jorgenrh/ET062G_VHDL_Range_Sensor/readme.md

Digital System Design with VHDL (ET062G) 

VHDL Range Measurement System

- Digilent Basys 3 Artix-7 FPGA
- SRF05 Range Sensor
- 12-bit VGA
- 7-Segment display

<!--
<center>
<img src="./images/system.png?raw=true" width="380" alt="System Overiew">
<img src="./images/design.png?raw=true" width="420" alt="Design Overiew">
</center>
-->
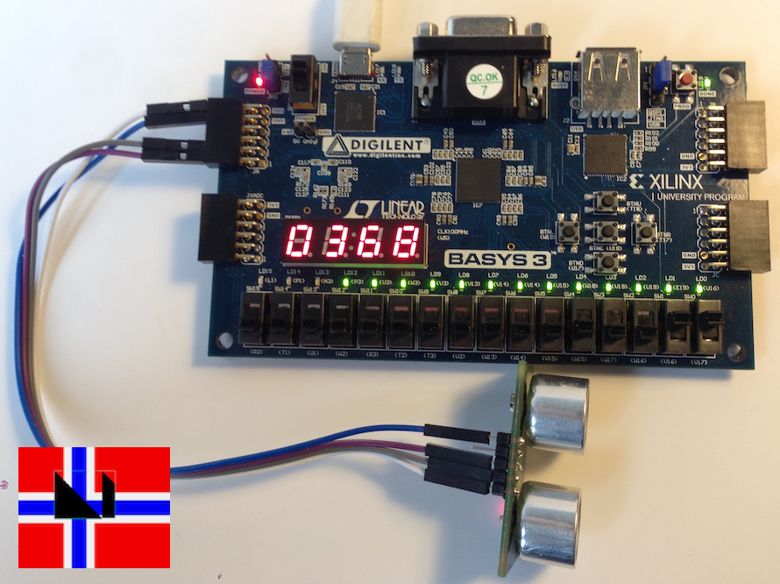
[picture p1: images/FPGA_SRF05.png]
VHDLProject FPGA Range Measurment System
