jorgenrh/ET062G_VHDL_Range_Sensor/reports/jrh_vhdl_report_ET062G.pdf

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

Abstract

This report describes the implementation, testing and results of a range measurement system using FPGA and VHDL. Besides the FPGA, the system is built using hardware such as a range sensor, VGA display, LEDs and 7-segement display. The system also makes use of hardware such as switches and push buttons for user interaction. The report is focused on the software side of the system in terms of VHDL and simulation and shows that the nal system is working accordingly to the project instructions.
The project is part of the Digital System Design with VHDL course (ET062G) at Mid Sweden University in Sundsvall, Sweden.

i

## Contents

1 Introduction | 1
2 Hardware | 2
3 Design and functionality | 4
4 Modules | 6
5 Simulation and verication | 16
6 Testing the system | 29
7 Results | 30
8 Discussion | 33
9 Conclusion | 33

ii

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

Introduction | J.R.Hoem
1 | Introduction

The main objective of this project is to learn how to interact with dierent kind of hardware using FPGA and VHDL. And gain experience in how to simulate, verify and test code as well as how to solve problems with VHDL.

The goal is to create a range measurement system using an ultrasonic range sensor, represent the data as a plot in a user-friendly manner on a VGA display, where the plot is surrounded by the ag of the student's home country.

For the sake of the length of this report, the report will assume that the reader has a basic understanding of VHDL, FPGA, VGA and Ultrasonic Range Sensors. This means that the report will not go in-depth on the hardware side of the project but instead focus on the software side in regards of implementation, simulation and verication.

The report will begin with a brief description of the required hardware. It will then present an overview of the design, and describe the code structure and functionality of the system.

All of the modules created and used in this project will be described before the simulations of the system is presented. The last part of the report will show how the testing of the system have been done, and then present the results in regards of accuracy and resource usage. The system as a whole will then be discussed before a short conclusion is given.

List of gures, tables and references can be found at the end of the report.

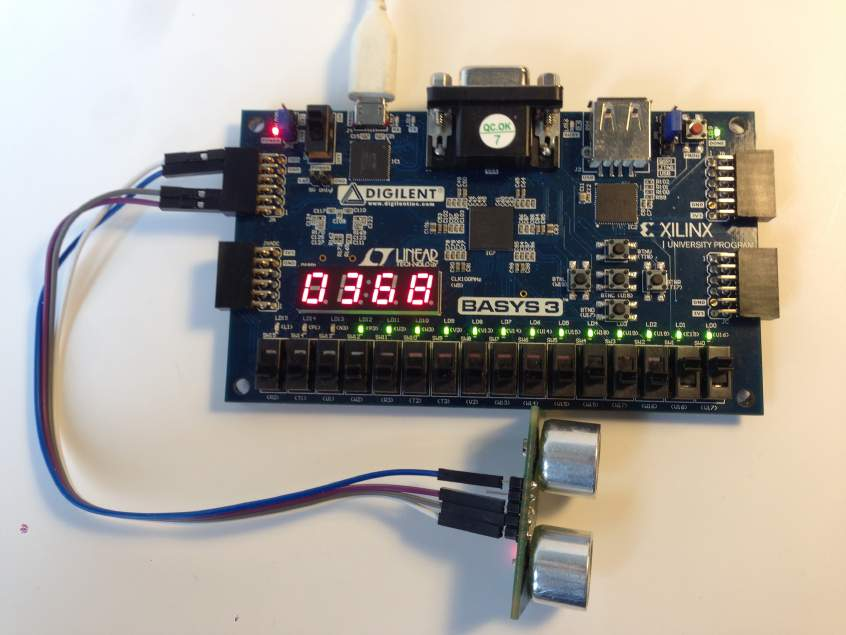
[picture p2: figure]

Figure 1: FPGA with the SRF05 connected

Digital System Design with VHDL (ET062G) | 1

J.R.Hoem | Hardware
2 | Hardware

This section will give a brief description of the hardware that is both required and used in this project.

2.1 The FPGA Development Board

The FPGA kit used in this project is the Basys 3 Artix-7 FPGA Trainer Board (Figure 1). This board contains the Xilinx Series-7 chip XC7A35T-1CPG236. Features that are most relevant to the project is listed in Table 1.

Basys 3 Artix-7 FPGA Trainer Board

Xilinx Artix-7 FPGA: XC7A35T-1CPG236 33,280 logic cells in 5200 slices
USB-powered (micro-B)
1,800 Kbits of fast block RAM
12-bit VGA output
16 user switches
16 user LEDs
5 user pushbuttons
4-digit 7-segment display

Table 1: Basys3 FPGA features

One of the goals have been to use as many of the boards peripherals as possible, such as the switches, LEDs, push buttons, 7-segment display and so forth.

2.2 | Ultrasonic Range Sensor

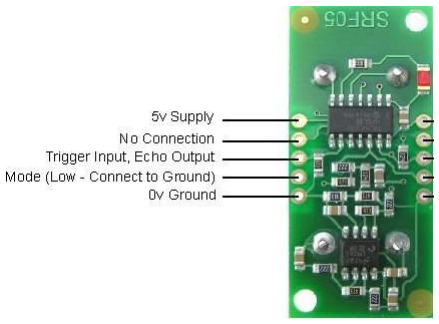
[picture p3: figure]
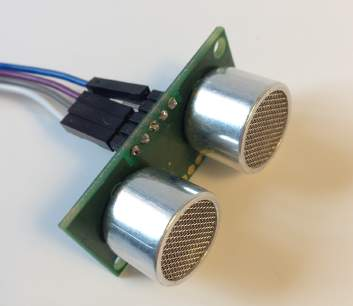
[picture p4: figure]

(a) SRF05 pinout | (b) SRF05

Figure 2: SRF05 ultrasonic range sensor

The range sensor used in this project is an ultrasonic range sensor called SRF05. This sensor is used in mode 1 which means that separate pins controls the sending and receiving of the trigger- and echo pulse.

2 | Digital System Design with VHDL (ET062G)

Hardware | J.R.Hoem

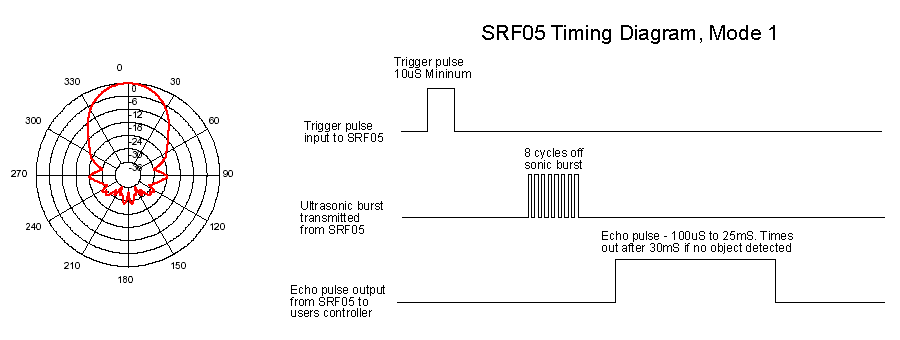
[picture p5: figure]

Figure 3: SRF05 beam prole and timing diagram

This sensor works by sending out an ultrasonic burst of 8 pulses at 40 kHz each time it receives a trigger pulse between 10 µs and 20 µs. The duration of the echo pulse will then represent the range. The range are then converted to centimeters by dividing the echo pulse length with 58.
Even though the SRF05 is rated for distances up to 400 cm (others claim 450 cm¹
), the timeout of the sensor is 30 ms which gives a theoretical range of up to 517 cm.

The sensor is rated for 5 VDC but have been supplied with 3.3 VDC directly from the FPGA board without any problems. This have been done to ease the process of testing.

2.3 VGA display

The FPGA provides an 12-bit VGA port which is used in this project. 12-bit VGA means that the RGB colors are represented with 4 bits each, hence RGB444.

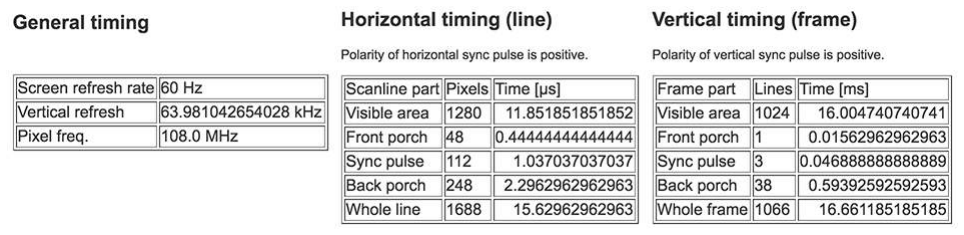
[picture p6: figure]

Figure 4: VGA timing data for 1280x1024 resolution[1]

The project is built using the VGA resolution 1280x1024 at a 60 Hz timing frequency. This requires a pixel clock of 108 MHz. Other key parameters used from Figure 4 is the vertical and horizontal front and back porch, and sync pulses.

1http://www.f15ijp.com/2012/09/arduino-ultrasonic-sensor-hc-sr04-or-hy-srf05/

Digital System Design with VHDL (ET062G) | 3

J.R.Hoem | Design and functionality
3 | Design and functionality
3.1 | Design overview

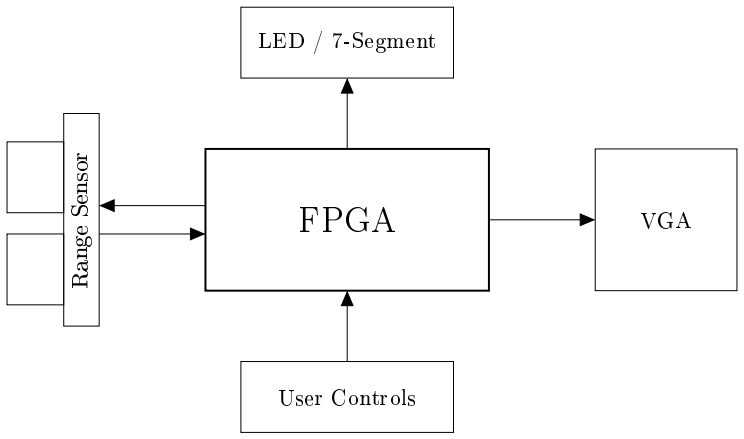
[picture p7: figure]
FPGA; Range Sensor; LED / 7-Segment; User Controls; VGA

Figure 5: System overview, block diagram

Figure 5 show the basic overview of the system and how the dierent hardware is interacting and connected together.

Clock | Top File

108 wiz

SRF05

Pulse | Echo | Divider

LED7Seg

BCD conv

VGA

RAM ctrl

BRAM

VGA ctrl | Flag

Figure 6: Design overview, block diagram

Figure 6 show how all of the VHDL components are structured and connected. One of the rst experiences gained from this project was that many components can quickly become quite messy. Thus, one of the important aspects have been to have a structured and logical component hierarchy.

3.2 Code description

All of the code is developed in Vivado 2015.1 with emphasizes to create a modular system and using material learned during the course. The code is also written as an attempt to follow best practices and the Xilinx guidelines.

4 | Digital System Design with VHDL (ET062G)

Design and functionality | J.R.Hoem

The system consist of a main top le that connects everything together. Subsystems, such as the VGA, SRF05 Sensor and so forth, are called cores and have the sux core in the entity- and le name. A core can can be considered as a driver for that particular subsystem and can contain processes as well as other components to work. Independent components, usually used by cores, have the sux module with exception of the Clock Generator.

Furthermore, all modules are written in lower case. General named signals have the sux in or out to avoid confusion. For clarity, port and generic mapping is done using named association instead of positional association. Files that are dependent of other components are using entity instantiation[2] instead of component instantiation. This is to make a leaner and more readable code that is less error-prone and less time consuming to change during the development.

Individual testbenches have been created for the main top le and each of the cores. With exception of the RAM module which has a verication module instead of a dedicated testbench. Though it has been manually simulated. Additionally, an individual testbench component have been made to simulate a VGA display. This is a standalone testbench component that is used both with the top le and the VGA core.

All of the les in this project is written by the author of this report, with exception of the 108 MHz clock generator and the VGA controller.

3.3 Functionality

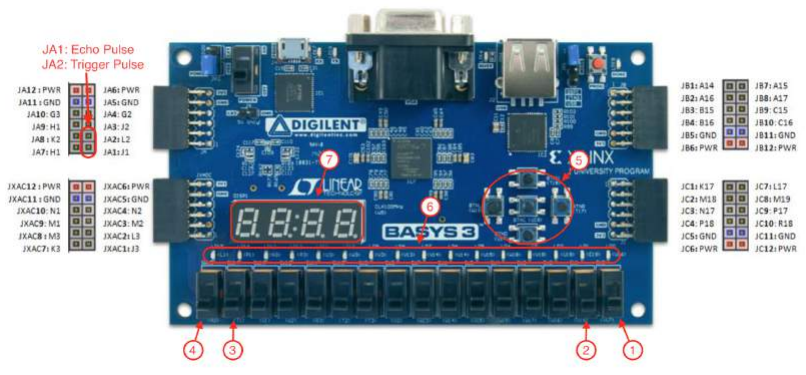
[picture p8: figure]

Figure 7: Board functionality map

1. Reset switch for the VGA (active low).
2. Enable switch for the range sensor (active high).
3. Switch for bisecting the sensor data displayed on the VGA. When on the full graph height is displayed, when o the height is divided by two.
4. Controls the data ow displayed on the VGA screen. When on the data is updated continuously, when o the data is only updated when new values occurs.
5. Control buttons, moves the graph to the desired location on the screen. The center button resets the position to default.
6. LED-meter that indicate the range from 0 to 450 cm, each LED represents 30 cm.
7. 7-segment display that shows the received sensor data in real time.
Digital System Design with VHDL (ET062G) | 5

J.R.Hoem | Modules
4 | Modules

This section will give a brief description of each of the cores and modules used in this project. Modules marked with extern in the title is not created by the author of this project. It is recommended to read the source code for a more in-depth description of the functionality.

4.1 Clock Generator

clock gen module

clock 100mhz in | clock 108mhz out clock 1mhz out

Figure 8: Entity of jrh_clock_gen_module.vhd

The clock generator was created to have one module that generate all of the necessary clock frequencies, 1 MHz and 108 MHz, for this project.

The 1 MHz clock, often referred to as the slow clock in this project, is made using a counter that downscale the 100 MHz input clock to 1 MHz. This clock drives all of the low speed components and functions such as the range sensor, RAM writing, LED-meter and the 7-segment display.

4.1.1 108 MHz clock (extern)

clk wiz 0

clk in1 | clk out1

Figure 9: Entity of clk_wiz_0.vhd

The 108 MHz clock is only used for the VGA display and thus also RAM reading. This clock is driven by the Mixed-Mode Clock Manager (MMCM) that is provided by the Xilinx FPGA. The code for this module was given with the instructions for laboratory exercise 1 and appears to be generated from a clock wizard. It has not been modied and is used as is.

6 | Digital System Design with VHDL (ET062G)

Modules | J.R.Hoem
4.2 | Range Sensor

srf05 core

clock in
enable in
echo pulse in

trig pulse out
distance out

Figure 10: Entity of jrh_srf05_core.vhd

The SRF05 core is the driver for the SRF05 Range Sensor and is dependent of three modules: Pulse generator, Echo pulse analyzer and a divider.

4.2.1 Pulse Generator

pulse gen module

clock in
enable in
pwidth in

pulse out

Figure 11: Entity of jrh_pulse_gen_module.vhd

The pulse generator module activates the range measurement by sending a trigger pulse to the sensor. The frequency of this pulse is 10 Hz and is sent continuously as long as the enable_in is set high. In other words, the enable_in signal controls whether or not the sensor is activated.

Due to the requirements from laboratory exercise 3 the code is structured so that the pulse width can be adjusted between 10 µs and 20 µs during runtime. This functionality have been partly disabled and the pulse width is set with a static width of 15 µs for this project.

4.2.2 Echo Pulse Analyzer

echo analyzer module

clock in
pulse in

duration out

Figure 12: Entity of jrh_echo_analyzer_module.vhd

The purpose of the echo analyzer is to measure the duration of the response pulse from the SRF05 sensor.
The duration is measured using a counter, and according to the SRF05 datasheet[3] a timeout occurs if the duration exceeds 30 ms this is also handled by this module. To avoid inconsistency in the readout the most recent duration value is set on the duration_out signal, this prevents ickering when new echo pulses arrives.
Digital System Design with VHDL (ET062G) | 7

J.R.Hoem | Modules
4.2.3 | 58 Divider

divider module

clock in
data in

data out

Figure 13: Entity of jrh_divider_module.vhd

The divider module have one task and that is to convert the duration received from the echo analyzer to centimeters. This is done by dividing the pulse duration with the number 58[3]

The distance is saved in a 16-bit wide logic vector, this size is used throughout the system with exception of the RAM. The reason for using 16-bit instead of the minimum 9-bit required is due to laboratory exercise 3 where pulse widths way above 400 µs was tested.

Since regular division requires a lot of resources and should be avoided on the FPGA, bitshifting have been used for division, as shown below.

Division (from jrh_divider_module.vhd)

37 | if to_integer(unsigned(data_in)) < 58 then
38 | data_out <= (others => ’0’);
39 | else
40 | -- since regular division should be avoided, (2^16)/58 = 1129,9 =>
| 1130.
41 | data_out <= std_logic_vector(resize(resize(unsigned(data_in) * 1130,
32) srl 16, 16));
42 end if;

For all values below 58 the data_out signal is set to 0. Other values is multiplied with 1130 into a temporary storage of 32 bits to avoid overow. It is then right shifted 16 positions and resized to a depth of 16 bits. The number 1130 comes from 2

16/58 = 1129.93 ≈ 1130 where 16 is the size of the logic vector.

This method was tested using Python²
. The result of the test showed that the approximation of 1130 can give an error of 0.78 %, at least in Python. In practice, this means that distances from 282 cm is rounded one up, 282 cm becomes 283 cm and so forth. This error could easily be accounted for in the code but since the range sensor already have an uncertainty of measurement[4] this have not been done.

4.3 RAM

The RAM implementation consists of two modules: the main RAM module and a RAM controller. Both modules are written with exibility and reuse in mind, and are therefor using generic variables to set the RAM length and depth, and address size.

2Python - https://www.python.org/

8 | Digital System Design with VHDL (ET062G)

Modules | J.R.Hoem
4.3.1 | RAM Module

ram module

clock in
read en
write en
read addr
write addr
write data

read data

Figure 14: Entity of jrh_ram_module.vhd

The RAM module is implemented as a generic RAM module with enable signals for read and write, signals for data input and output, and a signal for setting the read address and write data.

One of the goals have been to keep the RAM module as simple as possible and keep the structure more or less identical to the one written for laboratory exercise 2. Even though the size of the sensor data has a depth of 16 bits throughout this project, the storage in the RAM module is limited to the minimum size necessary which is a depth of 9 bits. This gives the RAM a size that is just above 4k, 512 × 9 = 4608 bit

The RAM is implemented as Block RAM to follow best practices. This is explained more thoroughly in section 5.4.1.

4.3.2 RAM Controller

ram ctrl module

clock in
write data
read addr

read data

continuous

Figure 15: Entity of jrh_ram_ctrl_module.vhd

The RAM controller works as a circular buer³
(also known as ring buer). One counter keeps track of the write index of the RAM memory. This index increases for each data that is written, and the read address is shifted accordingly in the controller as shown in Figure 16.

The controller also takes care of the read and write enable signals, and if the data should be written continuously or for new values only.

By implementing the RAM controller as a circular buer the RAM module is used as a simplied FIFO without modifying the RAM module itself.

3http://www.embedded.com/electronics-blogs/embedded-round-table/4419407/The-ring-buffer

Digital System Design with VHDL (ET062G) | 9

J.R.Hoem | Modules
0 | 1 | 2 | 3 | 4 | 5 | 6 | 7 | 8

write index

read index 0, 1, 2, . . .

RAM memory

Figure 16: Principle of circular buers, when increasing the write index the read index is shifted accordingly

4.4 VGA Display

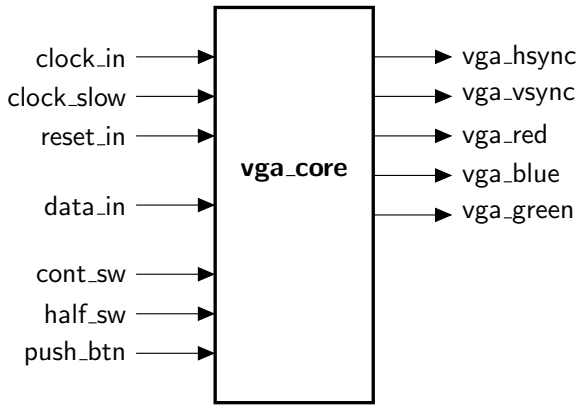
[picture p9: figure]
vga core; clock in clock slow reset in; data in; cont sw half sw push btn; vga hsync vga vsync; vga red vga blue vga green

Figure 17: Entity of jrh_vga_core.vhd

The VGA core is one of the more comprehensive sections in this project. It consists of three processes: sending data to the RAM controller, present the data on screen, controlling the position and layout of the presented data. It is also dependent of the RAM controller module, Flag Pattern module and the VGA controller module.

Saving Data Process

This process is pretty straight forward. It is a synchronous process using the slow clock (1 MHz), constrains the sensor data within 0 to 400 and sends it to the RAM controller which takes care of when and how it is saved.

Graphics Process

This process takes care of all the graphical elements drawn on the VGA display, such as the ag pattern, graph frame, horizontal meter and vertical bar plot. The data is read from the RAM controller and is clocked with the VGA clock at 108 MHz.

The division of the vertical bar plot height is also calculated in this process. This is controlled by a switch and is done the same way as the divider in the SRF05 core, using bit shifting to avoid regular division in the code.

Division of bar plot (from jrh_vga_core.vhd)

152 | if half_sw = ’0’ then
153 | -- if half size, divide data by 2 using right shift
154 | -- since regular division should be avoided, 2^9/2 = 256.
155 | data := to_integer(resize(resize(unsigned(read_data) * 256, 18) srl
| 9, 9));
10 | Digital System Design with VHDL (ET062G)

Modules | J.R.Hoem
156 | graph_h := 200;
157 | else
158 | data := to_integer(unsigned(read_data));
159 | graph_h := 400;
160 | end if;

Animation Process

This process uses all of the push buttons on the Basys3 board to control the position of the graph on the screen. The movement is controlled with a simple state machine where all of the four directions has its own state.

Setting move state (from jrh_vga_core.vhd)

271 if move = IDLE then

272
273 | if push_btn(0) = ’1’ then -- center
274 | graph_x := 703;
275 | graph_y := 100;
276 | elsif push_btn(1) = ’1’ then -- up
277 | y_end := graph_y - 10;
278 | move := MOVE_UP;
279 | elsif push_btn(2) = ’1’ then -- left
280 | x_end := graph_x - 10;
281 | move := MOVE_LEFT;
282 | elsif push_btn(3) = ’1’ then -- right
283 | x_end := graph_x + 10;
284 | move := MOVE_RIGHT;
285 | elsif push_btn(4) = ’1’ then -- down
286 | y_end := graph_y + 10;
287 | move := MOVE_DOWN;
288 | end if;

289
290 end if;

When one of the four buttons are pressed, a shared variable used by the Graphic Process will either increase or decrease depending on which state that is activated. The position update frequency is 200 Hz to give a smooth but notable transmission.The fth push button is used to reset the graph to the default position.

4.4.1 VGA Controller (extern)

vga ctrl module

pixel clk
reset n

h sync
v sync
disp ena
column
row
n blank
n sync

Figure 18: Entity of vga_ctrl_module.vhd

Digital System Design with VHDL (ET062G) | 11

J.R.Hoem | Modules

The VGA controller is the same as the one given for laboratory exercise 1. This code have not been modied and is used as is.

4.4.2 Flag Pattern

norwegian flag pattern

enable in
row
column

red
green
blue

Figure 19: Entity of jrh_norwegian_ag_pattern.vhd

The ag pattern module is heavily based on the pattern module given with laboratory exercise 1. This module uses the row and column position given by the VGA controller to determine which RGB444 color that should be sent to the VGA display.

This module can be considered as a background pattern for the VGA core and should thus be easy to replace with another pattern module with the same signal structure.

4.4.3 VGA Simulator (testbench component)

testbench comp vga2bmp

clock in

vga hsync
vga vsync

vga red
vga green
vga blue

snapshot

reading

Figure 20: Entity of testbench_comp_vga2bmp.vhd

The VGA simulator have been one of the more challenging but fun components created for this project. It is an addition to the VGA testbench and was created because it seemed like the best possible way to test the VGA core.

The purpose of the VGA simulator is to act as a real VGA display, therefore, it requires only the standard VGA signals to save one VGA frame as BMP if the snapshot is set high. The output signal, reading, is set high while the simulator is capturing.

This testbench component was created with reuse in mind, meaning the only conguration needed is width and height of the display, and vertical and horizontal back porch settings of the resolution.

VGA simulator conguration

1 | generic(
2 | bmp_width | : integer := 1280;
3 | bmp_height : integer := 1024;
4 | h_bporch | : integer := 248;
12 | Digital System Design with VHDL (ET062G)

Modules | J.R.Hoem
5 | v_bporch | : integer := 38;
6 | file_name | : string | := "C:\VHDL\VGA_output.bmp"
7 | );

The frame capturing works by waiting for the rst vertical sync signal if the snapshot signal is set high. When the vertical sync is received it compensates for the vertical back porch, before it starts capturing the RGB data between each horizontal sync pulse and horizontal back porch compensation.

The RGB data is converted from RGB444 to RGB888 and saved to a 2-dimensional array during capturing. When the frame is full the BMP header is created and the RGB array is reversed and written to the output le.

4.5 LEDs and 7-Segment Display

led7seg core

clock in
binary in

segment out
position out
led out

Figure 21: Entity of jrh_led7seg_core.vhd

This core serves as an direct indicator for the sensor value, meaning it does not store the data in RAM but output the data to the 7-segment display and 16 user LEDs directly. The advantages of this is that the raw distance can be read without any constrains, i.e. if the value exceeds the 400 cm range.

Two processes are used, one for controlling the LED-meter and one for the 7-segment display.

LED-meter Process

The LED-meter is a synchronous process using the slow clock. It is using Equation 1 to convert the distance into binary ones respectively.

led_out(d) = 2

16×

d
450
− 1 | (1)

To avoid dynamic (mathematical) operations within the code this formula have been translated into a static case structure where each case represent a step of 30 cm up to 450 cm. The upper limit of 450 cm is set intentionally since the sensor range in theory can exceed 400 cm.

7-Segment Display Process

The 7-segment display used is the one on the Basys3 board, this is a scanning display where the signals (LEDs) are active low[5]. The position of the digit is set low (active) and the 7 LEDs are turned on or o accordingly as shown in Figure 22.

Digital System Design with VHDL (ET062G) | 13

J.R.Hoem | Modules

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
abcdefg

0001111

Figure 22: 7-Segment Display numbering

The 7-segment display is driven by the slow clock (1 MHz). Two case structures are used, one for translating the BCD into the 7 segments respectively and one for the position of the digit. The update frequency of the display is set to 1 kHz, this is the fastest possible refresh rate according to the documentation.

Digit | 7-Segment | BCD
0 | 0000001 | 0000
1 | 1001111 | 0001
2 | 0010010 | 0010
3 | 0000110 | 0011
4 | 1001100 | 0100
5 | 0100100 | 0101
6 | 0100000 | 0110
7 | 0001111 | 0111
8 | 0000000 | 1000
9 | 0000100 | 1001

Table 2: 7-Segment Display conversion

The BCD conversion for the 7-segment display is dependent of the module described below.

4.5.1 Binary to BCD conversion

bin to 4bcd module

binary in | bcd3 bcd2 bcd1 bcd0

Figure 23: Entity of jrh_bin_to_4bcd_module.vhd

This module converts a 16 bit binary number into 4 binary-coded decimals (BCD). This is done by splitting the 16 bit number into 4 parts and then adjusting the 4 segments accordingly. The code is inspired from an online tutorial⁴

4http://www.deathbylogic.com/2013/12/binary-to-binary-coded-decimal-bcd-converter/

14 | Digital System Design with VHDL (ET062G)

Modules | J.R.Hoem
4.6 | Main Top le

jrh main top

clock in
enable in
reset in

echo pulse in

trig pulse out
led out

lcd segment
lcd position

vga hsync
vga vsync
vga red
vga blue
vga green

cont sw
half sw
push btn

Figure 24: Entity of jrh_main_top.vhd

The top le connects all the cores and modules together and does not contain any processes. The internal signals are distributed to each of the cores respectively, and the input/output signals are connect to the board through the constraint le.

The content of the top le can be viewed in Appendix 10.B or be found in Appendix 10.A.

Digital System Design with VHDL (ET062G) | 15

## 5 Simulation and verication

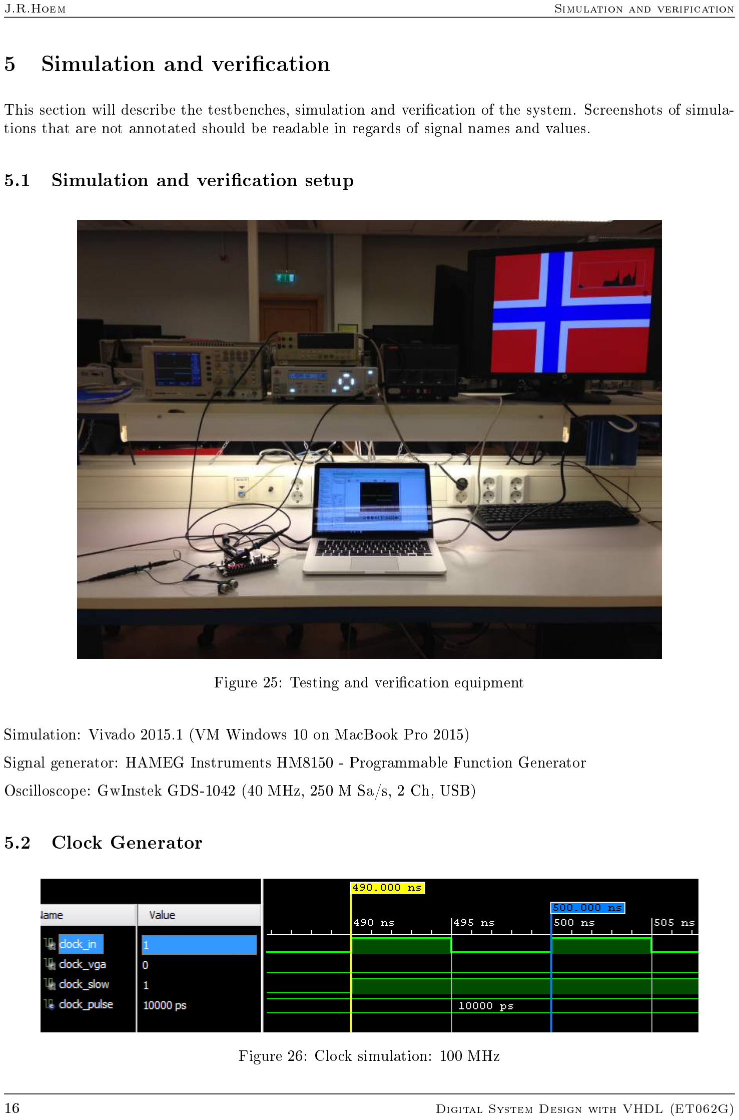
[picture p10: page 21]

J.R.Hoem | Simulation and verification

This section will describe the testbenches, simulation and verication of the system. Screenshots of simulations that are not annotated should be readable in regards of signal names and values.

5.1 Simulation and verication setup

Figure 25: Testing and verication equipment

Simulation: Vivado 2015.1 (VM Windows 10 on MacBook Pro 2015)

Signal generator: HAMEG Instruments HM8150 - Programmable Function Generator

Oscilloscope: GwInstek GDS-1042 (40 MHz, 250 M Sa/s, 2 Ch, USB)

5.2 Clock Generator

Figure 26: Clock simulation: 100 MHz

16 | Digital System Design with VHDL (ET062G)

Simulation and verification | J.R.Hoem

f =

1
500 ns − 490 ns
= 100 MHz | (2)

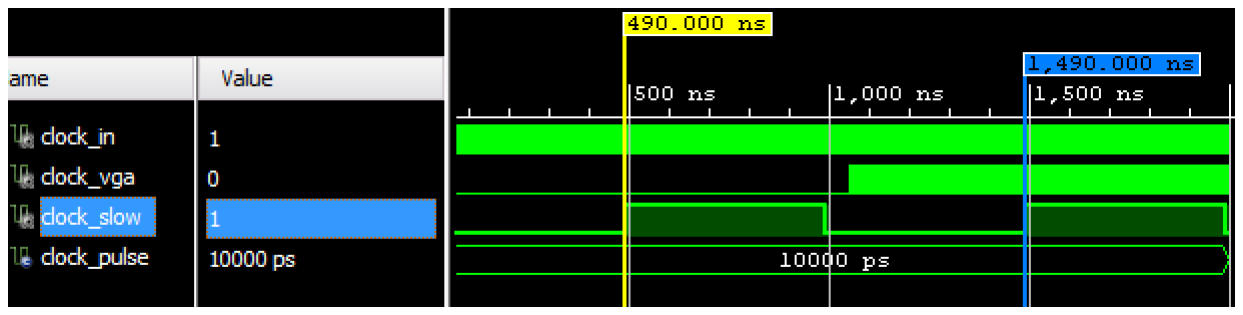
[picture p11: figure]

Figure 27: Clock simulation: 1 MHz

f =

1
1490 ns − 490 ns
= 1 MHz | (3)

The 1 MHz clock was veried using an oscilloscope, unfortunately, this was not documented at the time being.

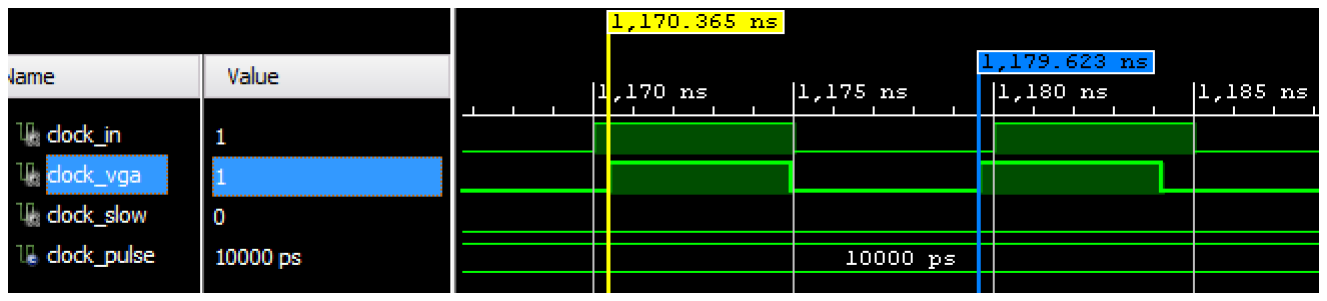
[picture p12: figure]

Figure 28: Clock simulation: 108 MHz

f =

1
1179.623 ns − 1170.365 ns
= 108 014 690 Hz ≈ 108 MHz | (4)
5.3 | Range Sensor

Manual simulation and testing have been done for each of the modules during development, the simulations described here will therefore only be based on the dedicated testbench since this summarizes the overall functionality.

5.3.1 Simulation

The testbench generates an echo pulse for each trigger pulse it receives. The echo pulse width is increased by 58 µs for every iteration.

Digital System Design with VHDL (ET062G) | 17

J.R.Hoem | Simulation and verification

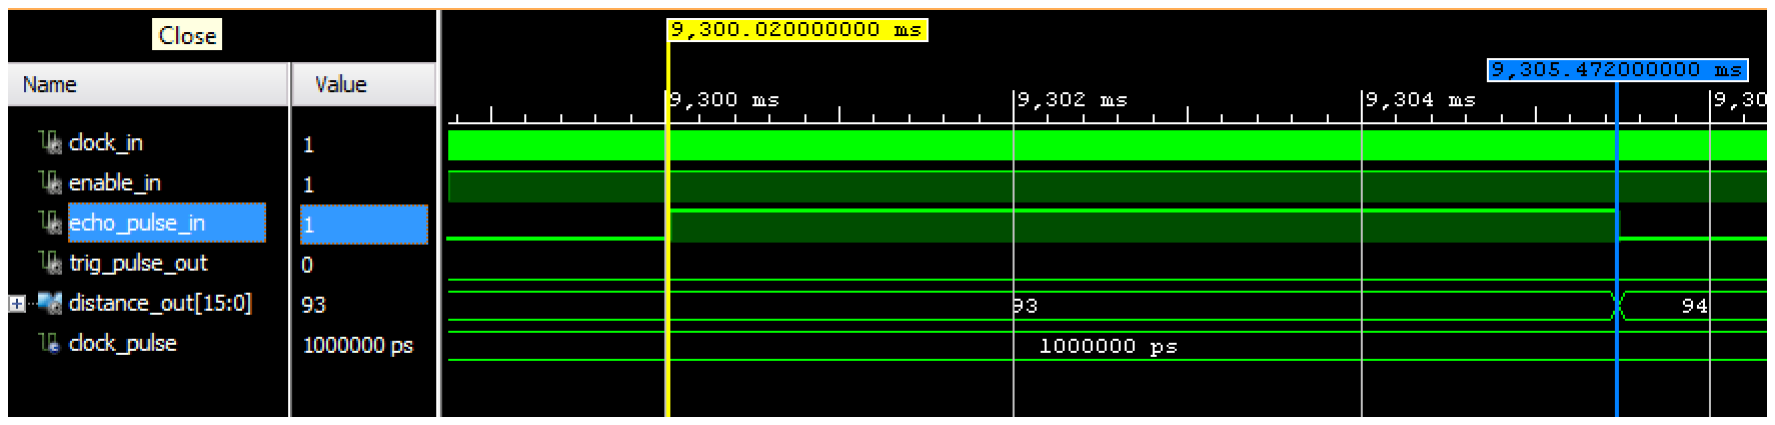
[picture p13: figure]

Figure 29: SRF05 simulation: echo pulse

Figure 29 shows a section from the simulation where the distance is 94 cm. By looking at the rising and falling edge of the echo pulse the distance is conrmed as shown in Equation 5.

d =

9305472 − 9300020
58
= 94 | (5)

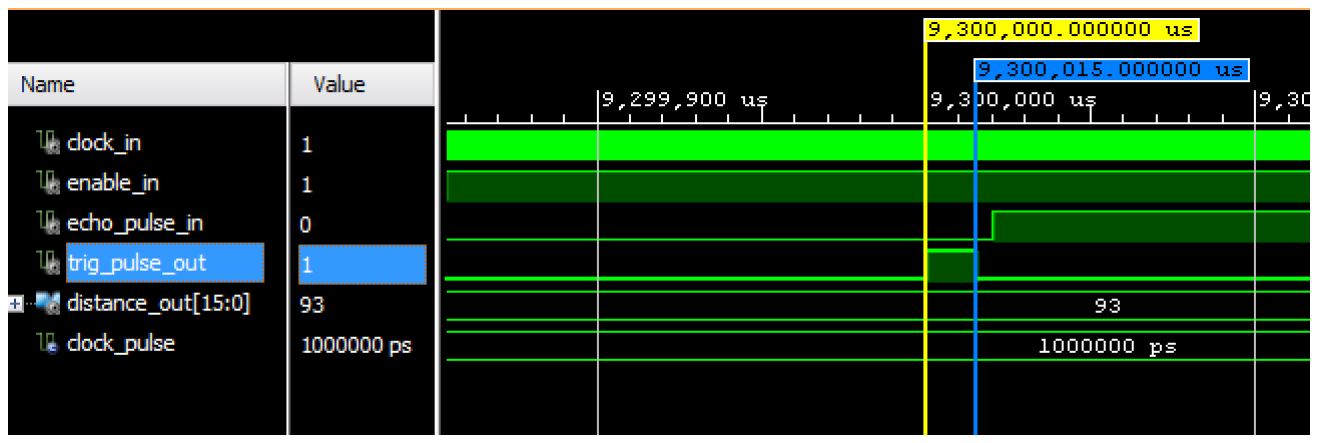
[picture p14: figure]

Figure 30: SRF05 simulation: trigger pulse width

A closer look at the trigger pulse shows that the width of the pulse is 15 µs.

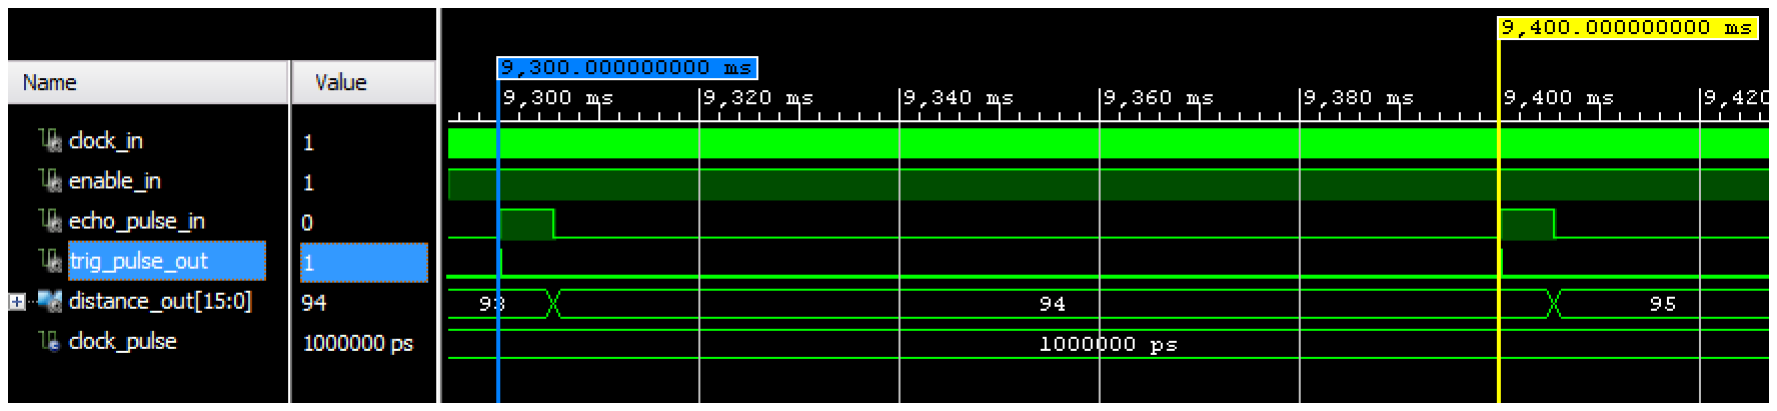
[picture p15: figure]

Figure 31: SRF05 simulation: trigger interval

The simulation also shows that the trigger pulse has an interval of 100 ms which gives a frequency of 10 Hz.

18 | Digital System Design with VHDL (ET062G)

Simulation and verification | J.R.Hoem
5.3.2 | Verication

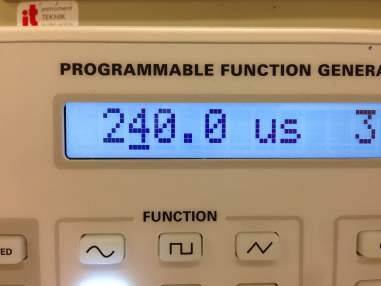
[picture p16: figure]
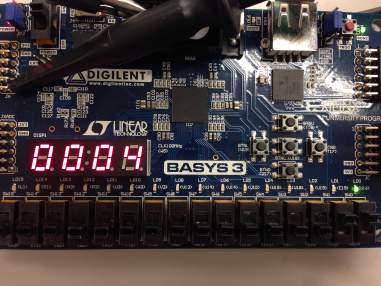
[picture p17: figure]

(a) Signal generator | (b) Board output

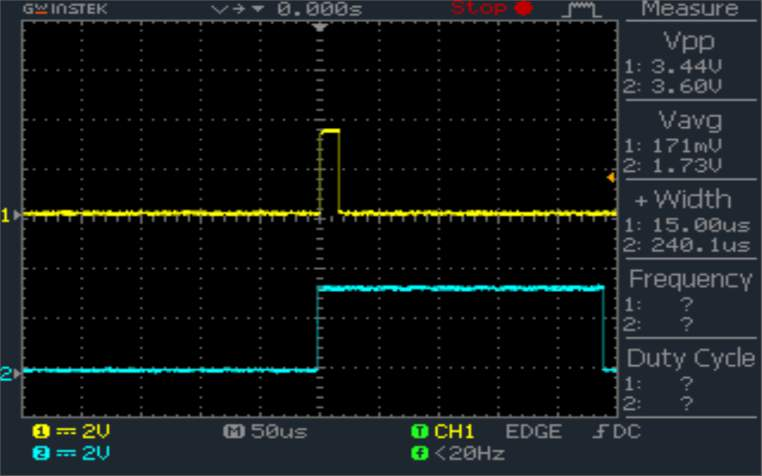
[picture p18: figure]

(c) Oscilloscope output of trigger pulse and echo pulse

Figure 32: Verifying SRF05 sensor using signal generator and scope

Figure 32 shows the verication of the echo pulse calculation. The signal generator simulates a 240 µs wide echo pulse that the FPGA translates to 4 cm. This is conrmed to be correct in Equation 6.

d =

240
58
= 4.1379 ≈ 4 | (6)

Figure 32b also shows the width of the trigger pulse to be 15 µs as the simulation indicated. A lot of dierent sized echo pulses was generated without any incorrect results. By generating a narrow echo pulse, such as the one in Figure 32a, the SRF05 core show that it is able to handle short distances.

Digital System Design with VHDL (ET062G) | 19

J.R.Hoem | Simulation and verification
5.4 | RAM
5.4.1 | Implementation

There are three ways of implementing RAM on the Xilinx FPGA. Dene it as RAM using LUTRAM (Distributed RAM) or BRAM (Block RAM), or using regular LUT/FF for implementation. Each of these methods have been tested and compared to nd the best suited implementation for this project.

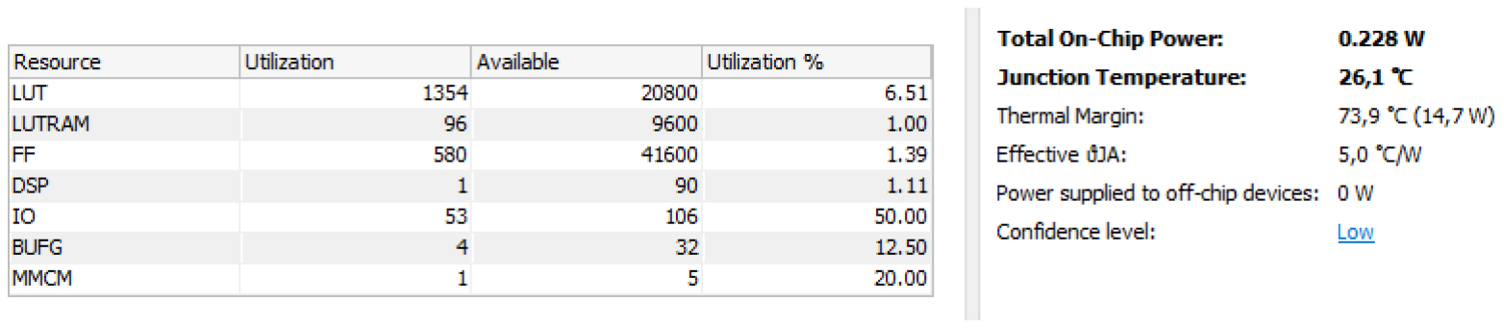
[picture p19: figure]

(a) LUTRAM implementation

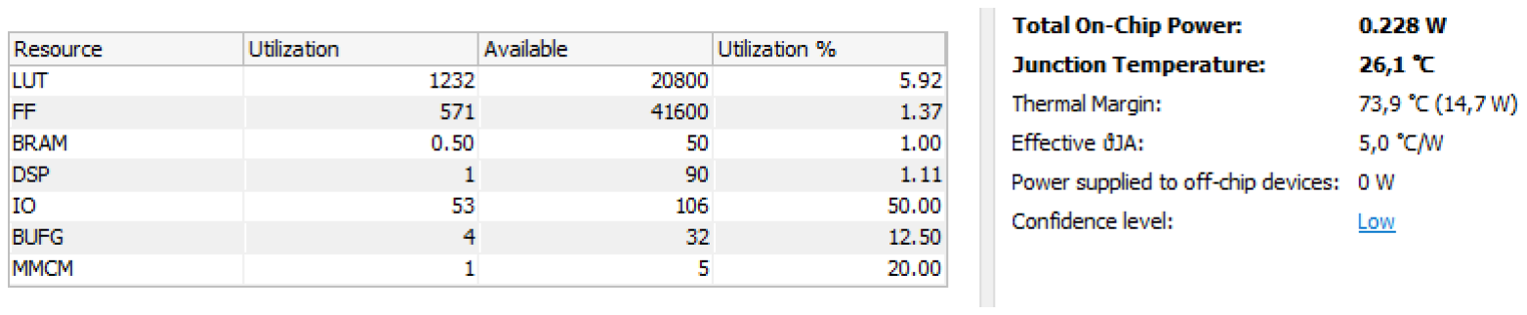
[picture p20: figure]

(b) BRAM implementation

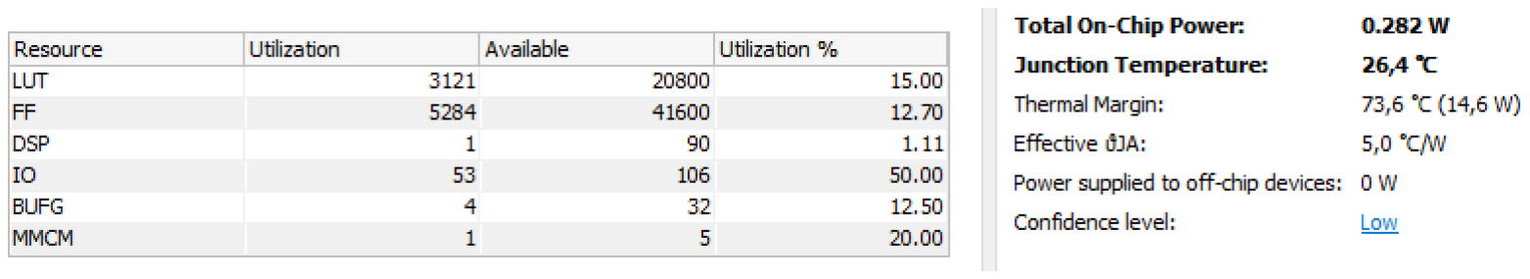
[picture p21: figure]

(c) LUT/FF implementation

Figure 33: Dierent RAM implementations

According to the Xilinx documentation as a rule of thumb, memory sizes below 4 kbit should be implemented as LUTRAM and anything above as BRAM[6]. As mentioned earlier the memory size in this project is 4.608 kbit which is quite close to 4k. Comparing LUTRAM against BRAM, as expected, did not show any major dierences. Except that BRAM gives slight reduction in the use of LUT and FF. The documentation shows that a more critical dierence between LUTRAM and BRAM is to be expected if the memory size is lager.

A more notable dierence arise when comparing LUTRAM and BRAM against LUT/FF, this concerns both power consumption and junction temperature. Using LUT/FF increases the power consumption around 23 %, from 0.228W to 0.282W, and the junction temperature by 0.3

◦C.

As a result of this the RAM in this project has been implemented as BRAM. This also makes it easier to expand the memory size for free in future revisions, if needed, without compromising the power consumption. It should be noted that the BRAM has a delay of one clock cycle, but this is not an issue in this project.

20 | Digital System Design with VHDL (ET062G)

Simulation and verification | J.R.Hoem
5.4.2 | Simulation

A verication module have been created for the RAM module instead of a dedicated testbench. This is to be able to test and verify the memory behavior using the switches on the Basys3 board. The verication module lls the RAM with data from 0 to 399, 9 of the switches on the board sets the read address and the read data is displayed as a binary value using the LEDs.

| RAM verication (from verication_ram_module.vhd)
72 | if ram_full = ’1’ then -- read address by using switches

73
74 | read_en <= ’1’;
75 | read_addr <= switch_in;
76 | led_out <= read_data;

77
78 else -- fill ram once

79
80 | if count <= 399 then
81 | write_en <= ’1’;
82 | write_addr <= std_logic_vector(to_unsigned(count, 9));
83 | write_data <= std_logic_vector(to_unsigned(count, 9));
84 | count := count + 1;
85 | else
86 | write_en <= ’0’;
87 | ram_full <= ’1’;
88 | count := 0;
89 | end if;

90
91 end if;

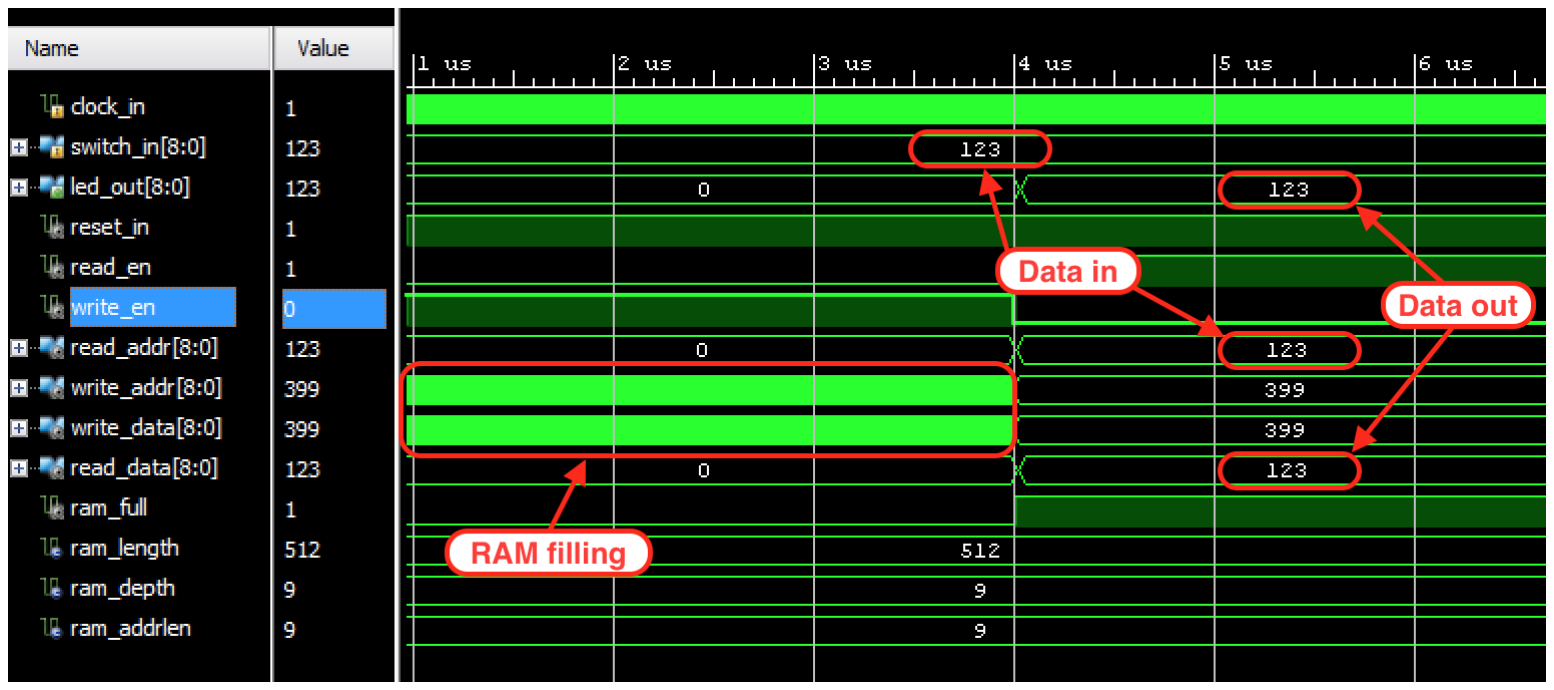
[picture p22: figure]

Figure 34: Simulation of RAM verication

Figure 34 shows that after the RAM is full and setting the switches in a position that represent memory address 123, the read_data shows the corresponding value from the RAM which is sent to the LED output.

Digital System Design with VHDL (ET062G) | 21

J.R.Hoem | Simulation and verification
5.4.3 | Verication

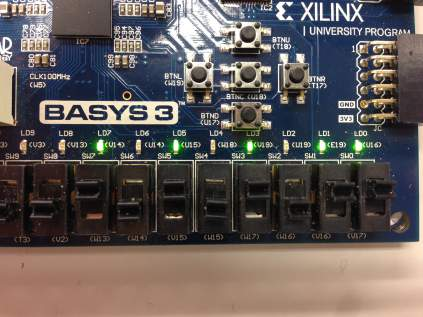
[picture p23: figure]
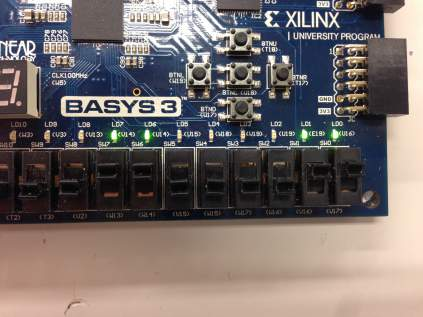
[picture p24: figure]

(a) Reading address 171 | (b) Reading address 195

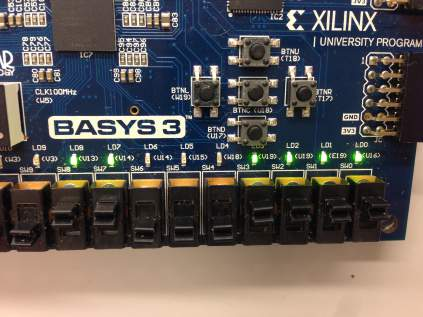
[picture p25: figure]
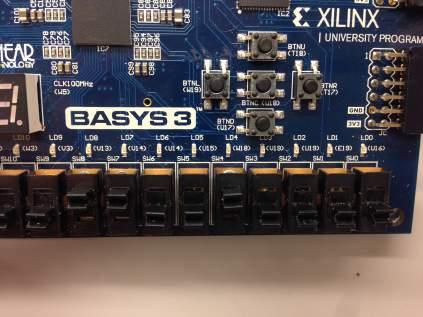
[picture p26: figure]

(c) Reading address 399 | (d) Reading address 400

Figure 35: Verifying RAM memory by using LEDs

Testing the code on the FPGA shows that by setting the switches to address 399 the corresponding binary value is displayed on the LEDs. When increasing the address to 400, the read value is 0 as expected. Multiple addresses was tested and all seemed to work as intended.

5.5 RAM Controller

This testbench includes the clock generator since the RAM controller is using the vga clock (108 MHz). To make examination of the circular buer easier, the RAM block length has been set to 5 instead of 512. Furthermore, the continues mode on the controller is disabled, meaning only new values are written to the RAM.

The testbench writes a value starting from 100 at the speed of the slow clock (1 MHz), this value decreases by one for every iteration. While another process is reading the RAM at a frequency of 108 MHz.

22 | Digital System Design with VHDL (ET062G)

Simulation and verification | J.R.Hoem

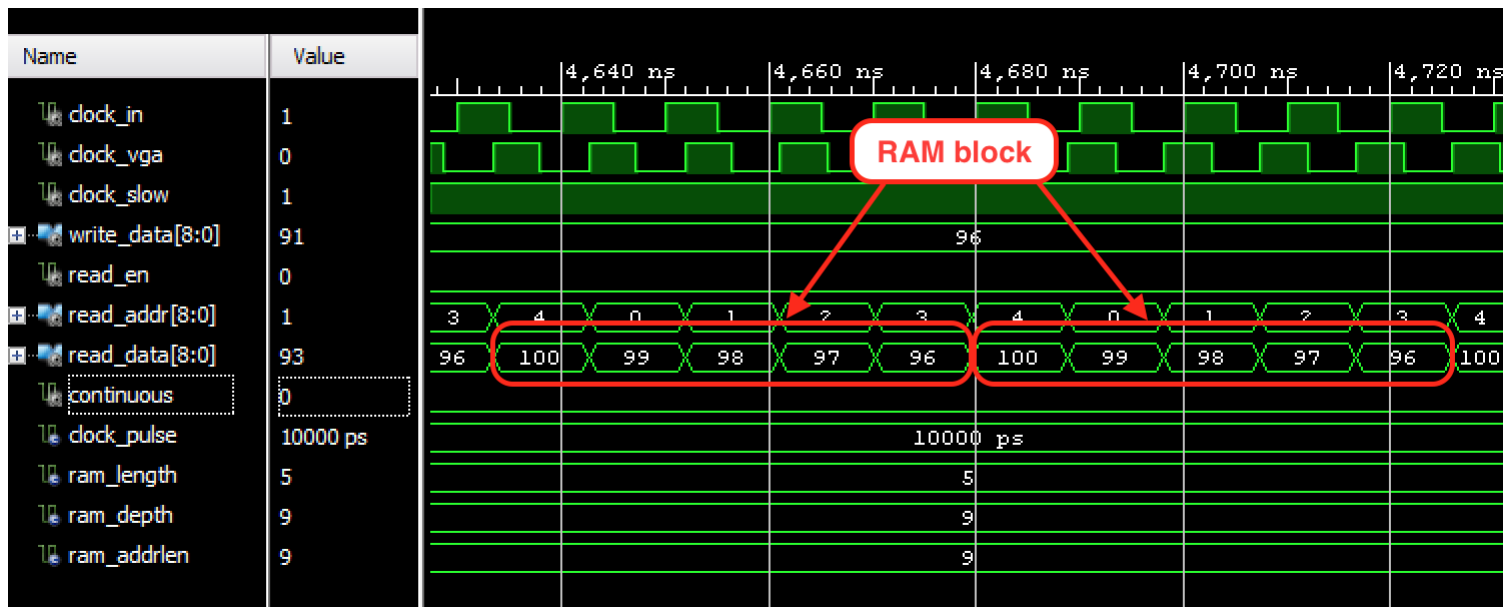
[picture p27: figure]

(a) Plot at default position

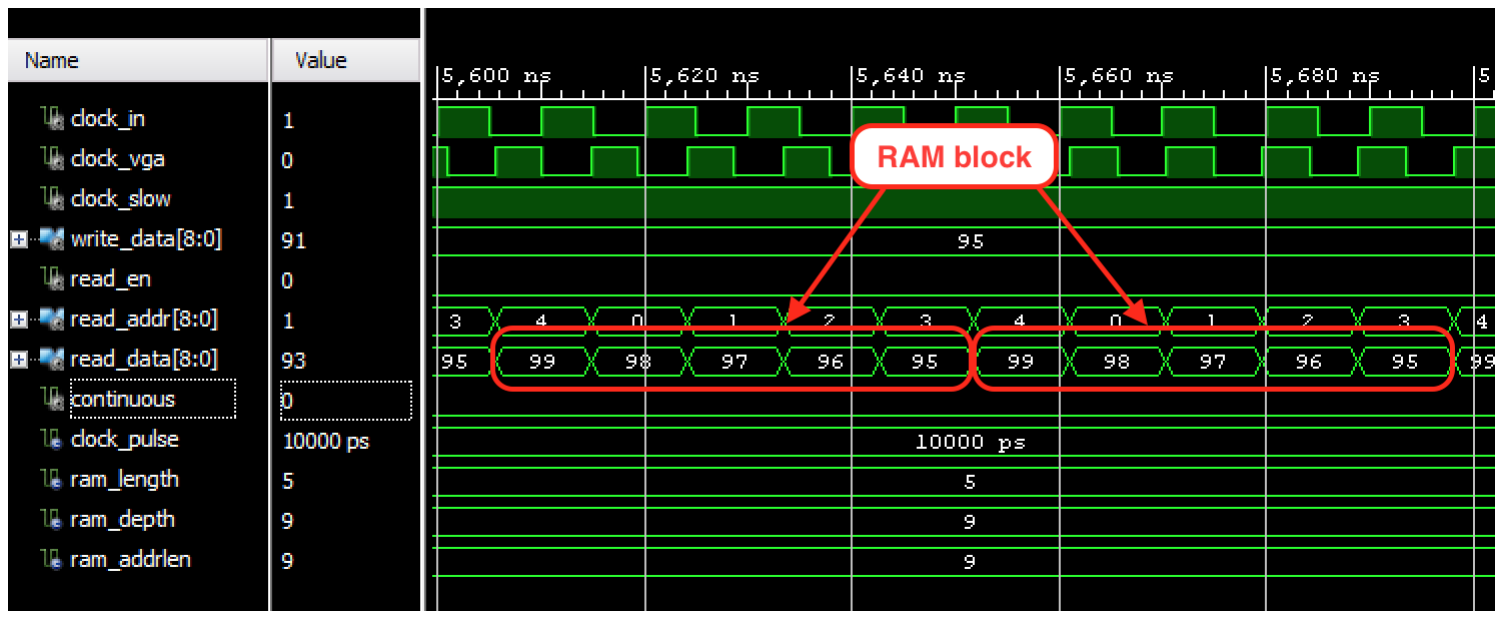
[picture p28: figure]

(b) Plot moved with full height

Figure 36: RAM controller testbench

Comparing Figure 36a with Figure 36b shows that the RAM data is shifted one position and that the FIFO functionality is working as intended.

5.6 VGA

The testbench written for the VGA core consists of two les: the VGA core testbench and the VGA simulator, as mentioned earlier.

The testbench simulates sensor data from 0 to 400 twice and then captures the rst complete VGA frame. Since the VGA controller does not send a vertical synchronization signal before the second frame, and the VGA frequency is 60 Hz, the simulation time required is around 34 ms.

Digital System Design with VHDL (ET062G) | 23

J.R.Hoem | Simulation and verification

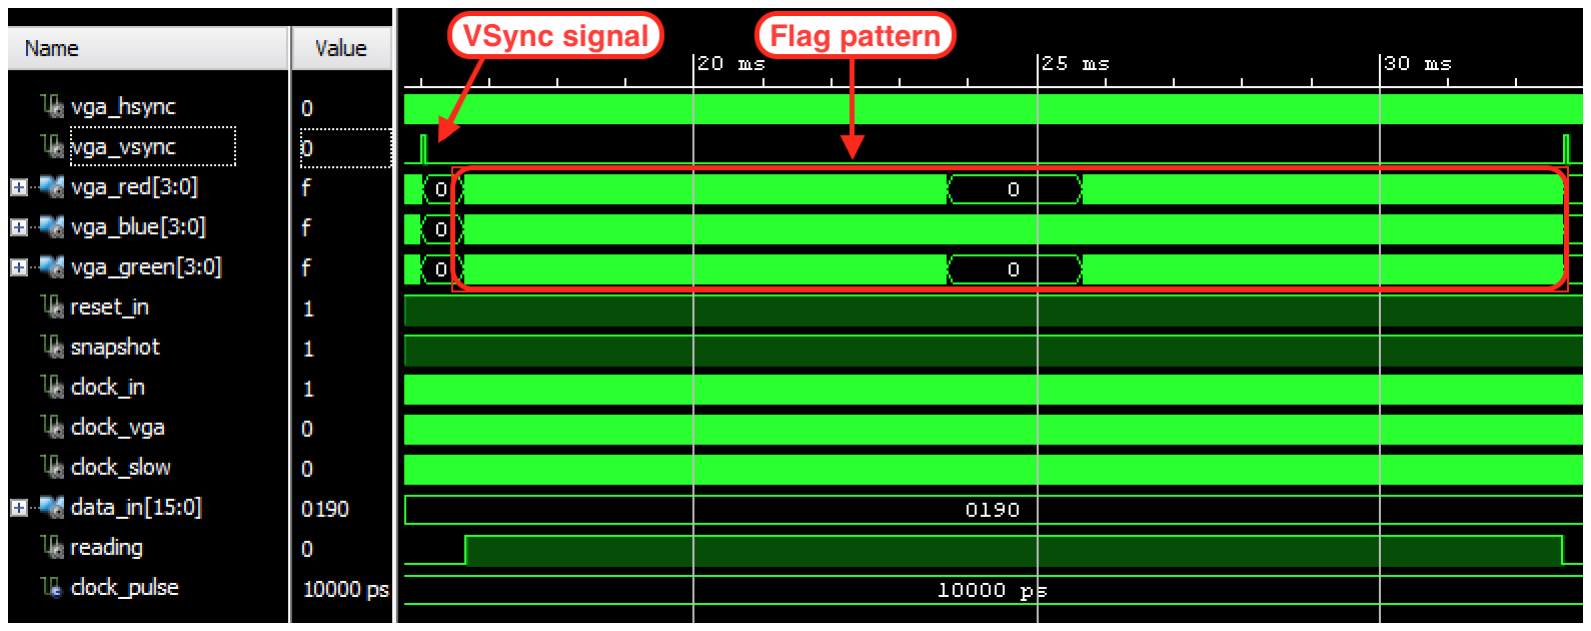
[picture p29: figure]

Figure 37: VGA testbench result

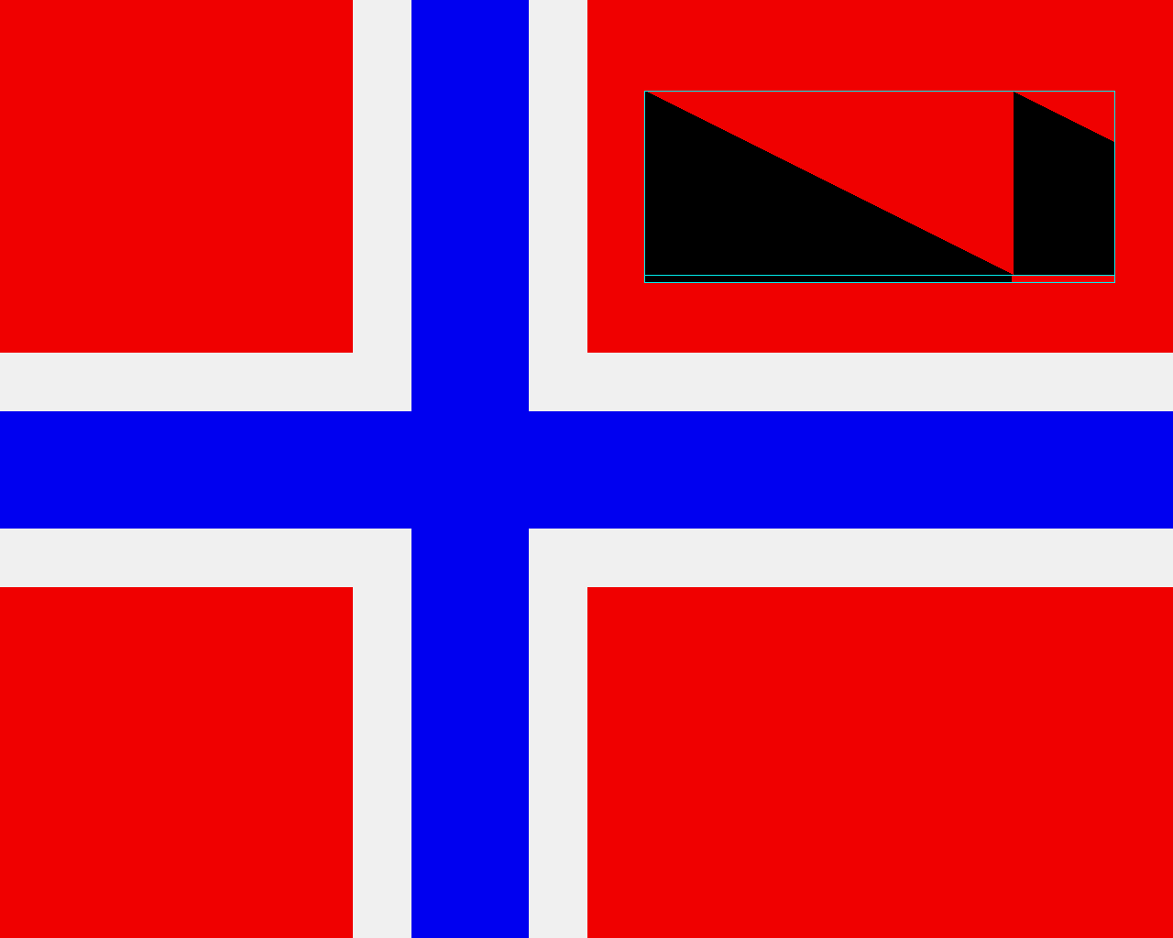
[picture p30: figure]
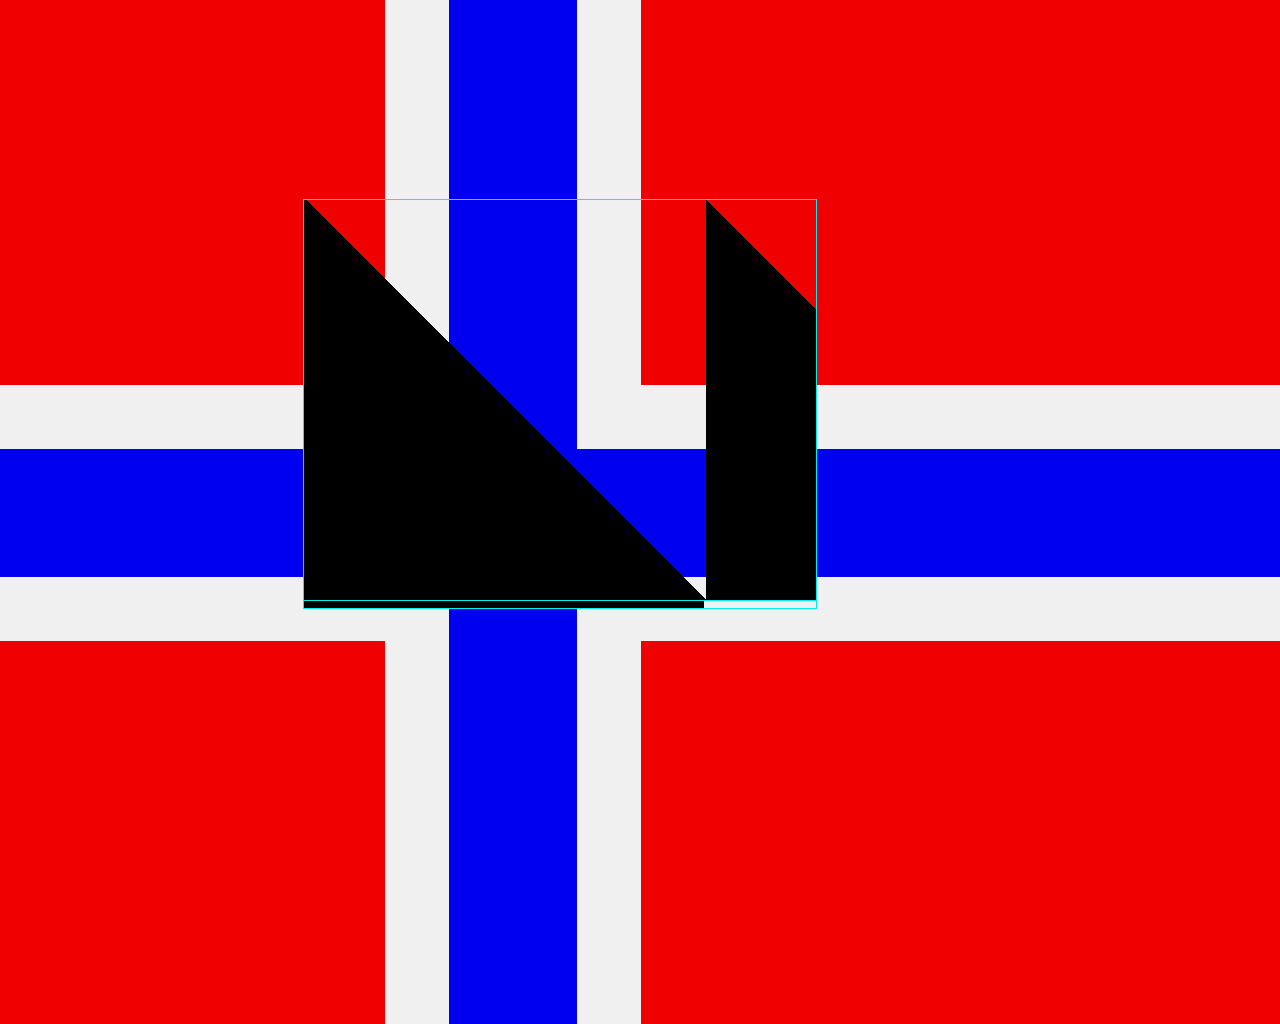
[picture p31: figure]

(a) Plot at default position | (b) Plot moved with full height

Figure 38: VGA to BMP simulation result

As shown in Figure 38, the ag pattern, the RAM controller and the presentation of the sensor data at dierent positions works as intended.

A larger image of the VGA output can be viewed in Appendix 10.D.

5.7 LED and 7-Segment Display

The LED and 7-Segment testbench was simulated using two dierent input numbers. One within the range of the sensor and one way above the range. This is to conrm the behavior of both the display and the LED-meter.

24 | Digital System Design with VHDL (ET062G)

Simulation and verification | J.R.Hoem

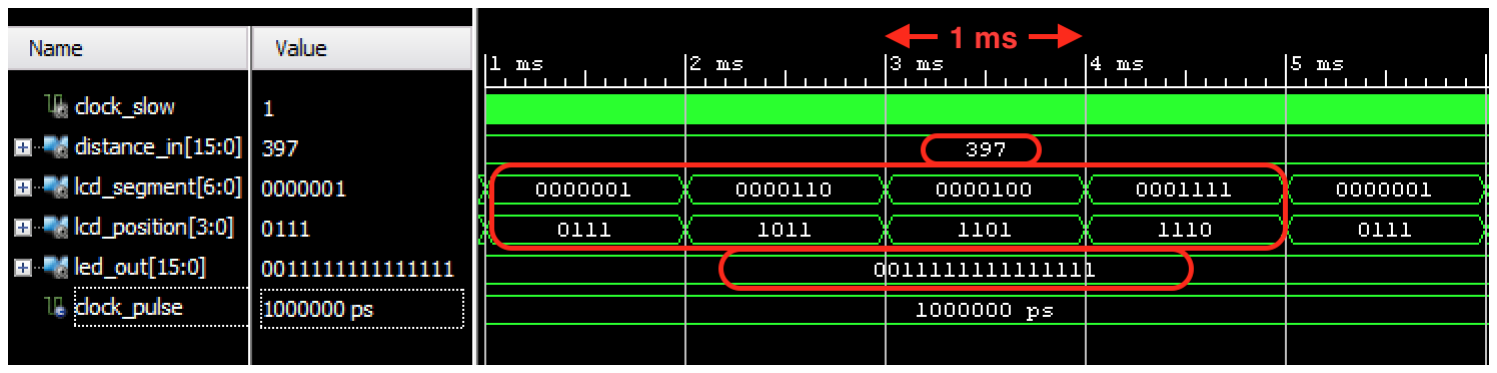
[picture p32: figure]

Figure 39: LED and 7-Segment testbench: 397 digit simulation

0111

0000001

1011

0000110

1101

0000100

1110

0001111

0011111111111111

Figure 40: LED and 7-Segment testbench: 397 result

Figure 39 with the corresponding Figure 40 show that the indicators are working as expected. The 7-segment refresh rate of 1 kHz is also conrmed by the simulation.

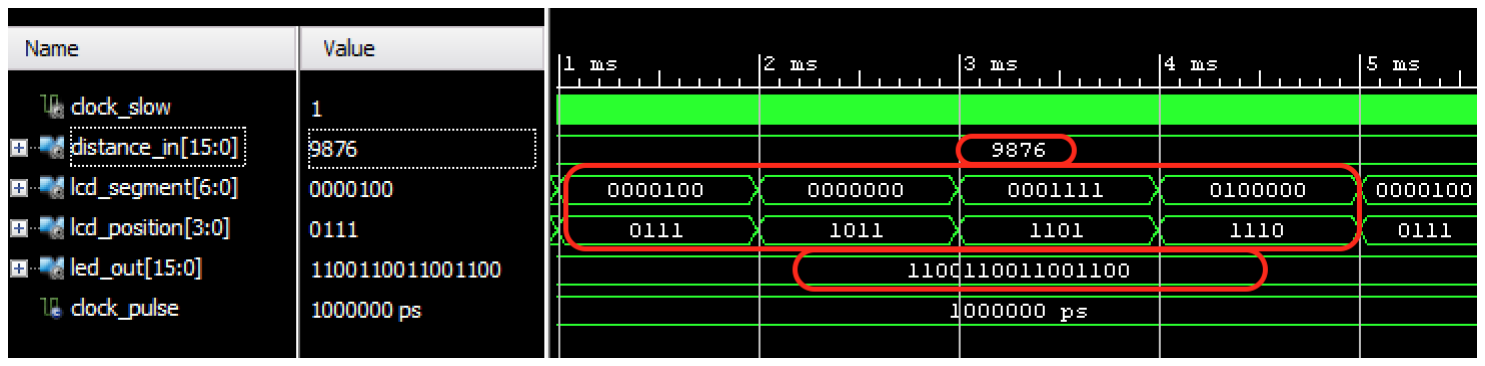
[picture p33: figure]

Figure 41: LED and 7-Segment testbench: 9876 digit simulation

Digital System Design with VHDL (ET062G) | 25

J.R.Hoem | Simulation and verification

0111

0000100

1011

0000000

1101

0001111

1110

0100000

1100110011001100

Figure 42: LED and 7-Segment testbench: 9876 result

Figure 41 and Figure 42 shows that all four digits of the 7-segment display is working. Since this value is outside the scope of the LED-meter, the catch all case from the case structure is active, hence the out-of-range pattern on the LED-meter is displayed.

5.8 Top File

Due to the long interval between the trigger pulse (100 ms) the testbench for the top le simulates an echo pulse directly instead of waiting for the trigger pulse. This echo pulse is 14.5 ms wide and should return a measured distance of 250 cm.

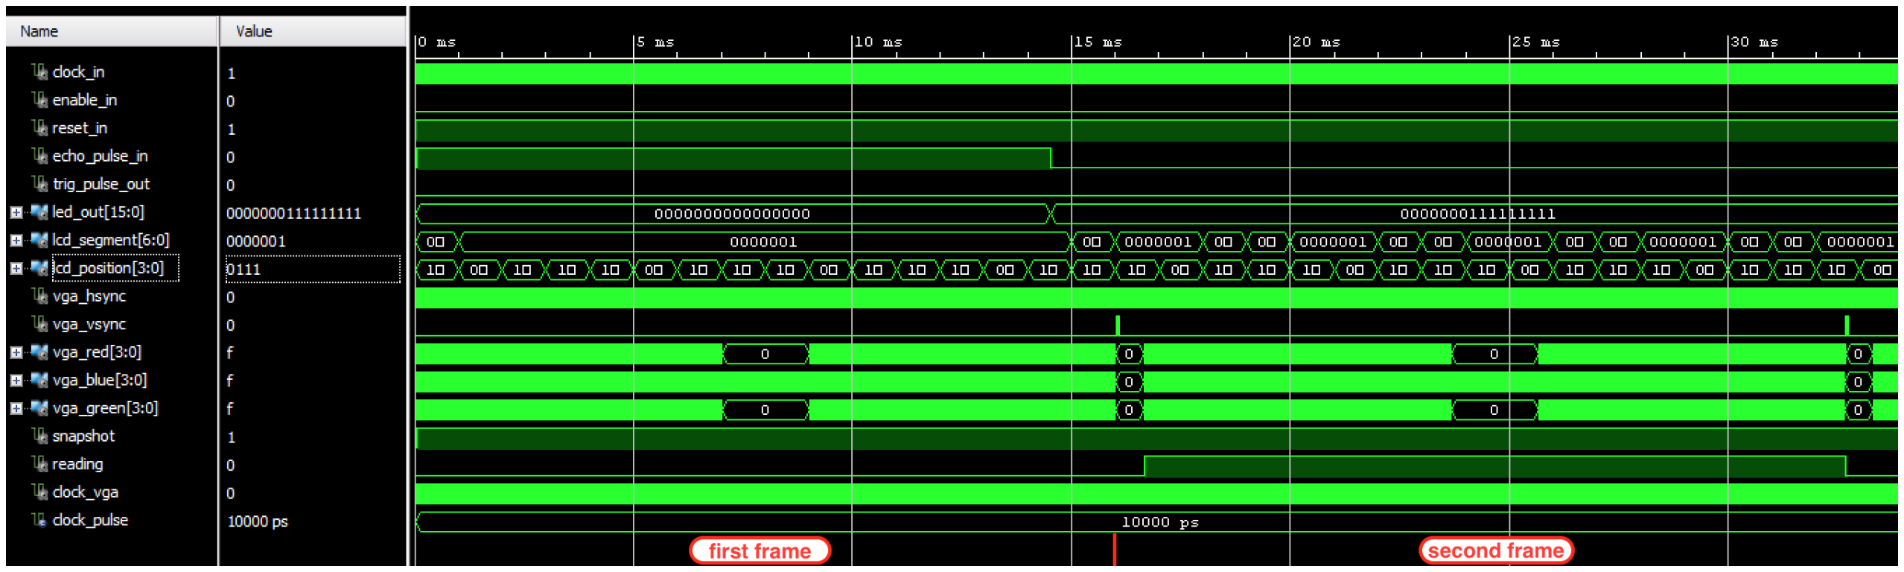
[picture p34: figure]

Figure 43: Top le testbench simulation results

Figure 43 shows the simulated echo pulse, LED-meter, 7-segment data and two VGA frames where the last one is captured by the simulator. It also shows that the echo pulse duration is converted into distance at the falling edge of the echo_pulse_in signal.

26 | Digital System Design with VHDL (ET062G)

Simulation and verification | J.R.Hoem

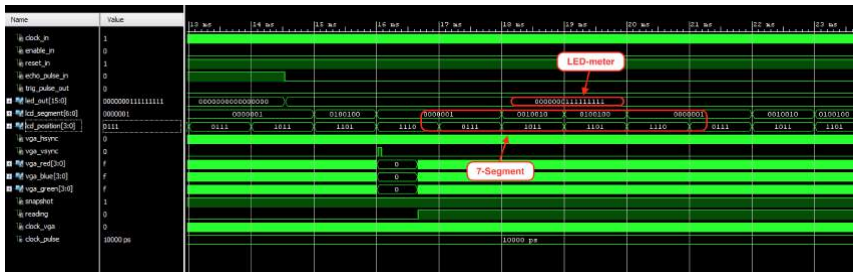
[picture p35: figure]

Figure 44: Top le testbench simulation results LED/7-Seg

Figure 44 shows that the LED-meter is set to 0000000111111111. Since each LED represent 30 cm, this corresponds to a distance between 240 to 270 cm which is correct.

0000000111111111

Figure 45: Top le testbench: LED-meter

Taking a closer look at the 7-segment display output and comparing it against Table 2 gives the number 250 as shown in Figure 46.

0111

0000001

1011

0010010

1101

0100100

1110

0000001

Figure 46: Top le testbench: 7-segment display

Digital System Design with VHDL (ET062G) | 27

J.R.Hoem | Simulation and verification

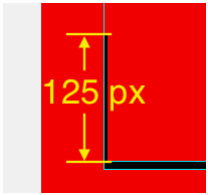
[picture p36: figure]
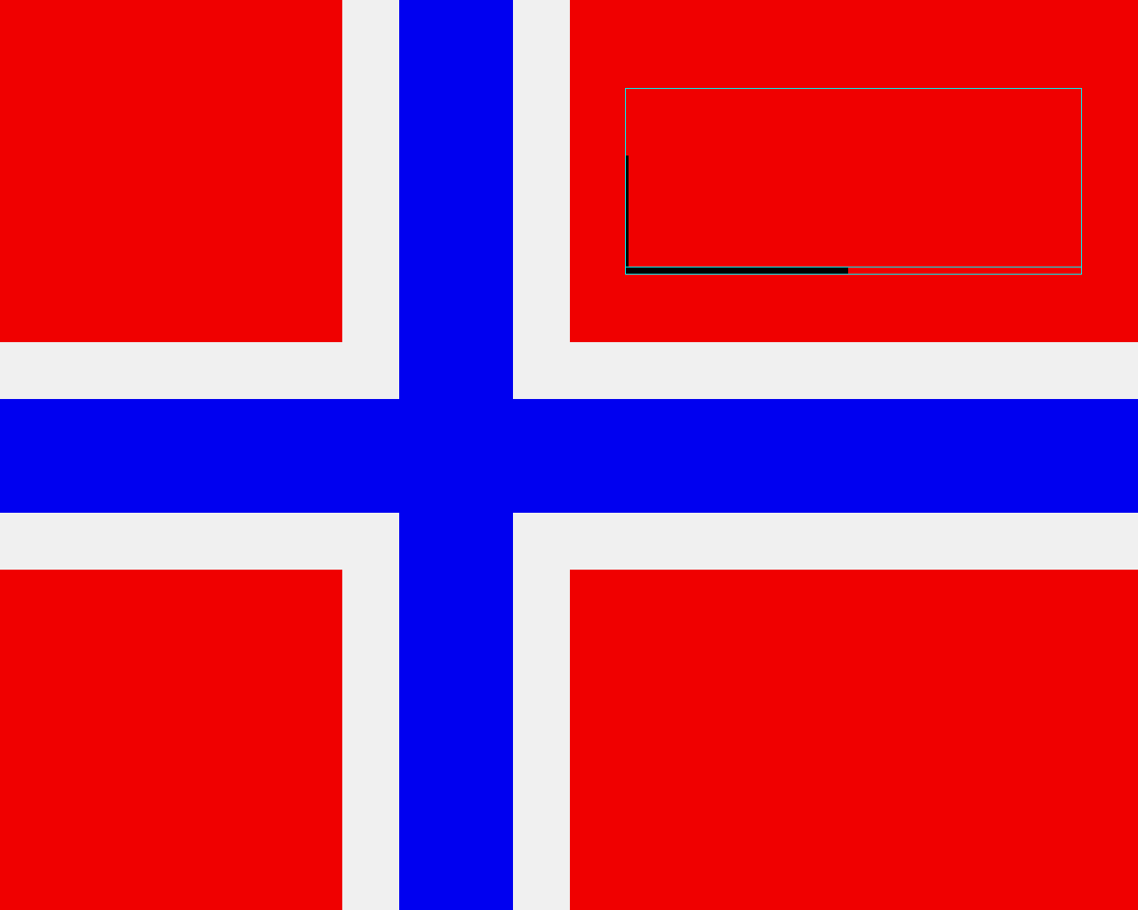
[picture p37: figure]

(a) VGA output | (b) Bar Plot

Figure 47: Top le testbench: BMP result

Furthermore, zooming in on the BMP output image shows that the bar height of the plot is 125 px high, this is correct since the bar plot by default is divided by 2.

Larger images of the testbench results can be viewed in Appendix 10.C.

28 | Digital System Design with VHDL (ET062G)

Testing the system | J.R.Hoem
6 | Testing the system

Two types of measurements were done to test the behavior of the system in practice. One short range measurement and one long range measurement.

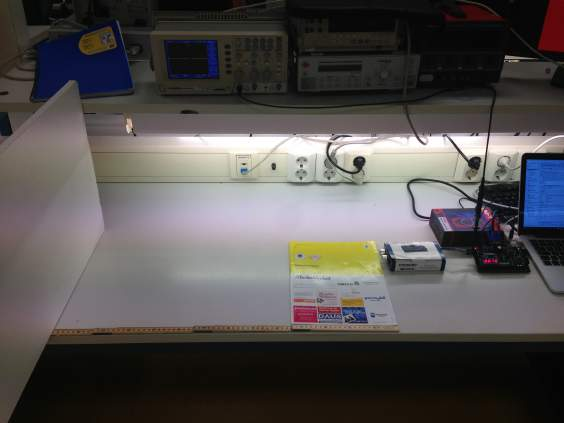
[picture p38: figure]

Figure 48: Testing environment: short range

The short range measurement was rigged to be as accurate as possible but seemed to be subject to surrounding noise. Distances measured was 5, 10, 15, 20, 25, 30, 50, 70 and 90 cm.

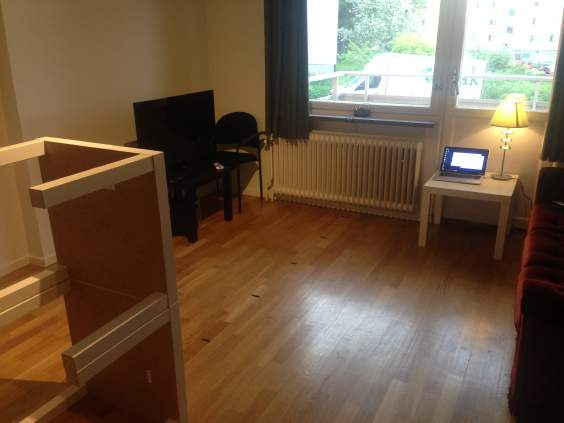
[picture p39: figure]

Figure 49: Testing environment: long range

The long range measurement was done in a clean and open environment. Distances of 50 cm up to 400 cm was marked using a folding ruler. The reecting object was calibrated at 50 cm since this distance proved to be accurate during the short range test.

Digital System Design with VHDL (ET062G) | 29

J.R.Hoem | Results
7 | Results

Complete reports from Vivado can be found in Appendix 10.A.

7.1 | Accuracy
0 | 2 | 4 | 6 | 8 | 10
Measurement

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
e [c

m]

Long Range Test

Actual Distance
Measured Distance
(a) Long range plot
0 | 1 | 2 | 3 | 4 | 5 | 6 | 7 | 8
Measurement

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
e [c

m]

Short Range Test

Actual Distance
Measured Distance
(b) Short range plot

Figure 50: Result: Long and short range plot

Range [cm] | Measured [cm]
50 | 50
100 | 100
150 | 150
200 | 199
250 | 249
300 | 299
350 | 350
400 | 400
433 | 433
480 | 480

Table 3: Long range test result

Range [cm] | Measured [cm]
5 | 7
10 | 11
15 | 15
20 | 20
25 | 25
30 | 30
50 | 50
70 | 71
90 | 91

Table 4: Short range test result

By comparing the mean values the long range test give an error of 0.11 %, while the short range test give an error of 1.59 %. This deviation of the measurement can also be seen in Figure 50. For the long range test the deviation was negative while in the short range the deviation was positive. With exception of the shortest range the deviation was 1 cm in all cases.

30 | Digital System Design with VHDL (ET062G)

Results | J.R.Hoem

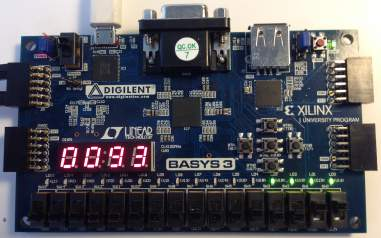
[picture p40: figure]
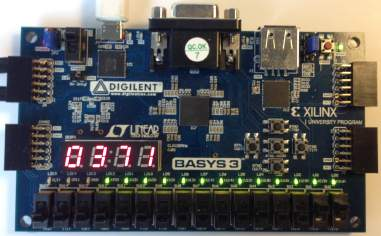
[picture p41: figure]

(a) 93 cm measured | (b) 371 cm measured

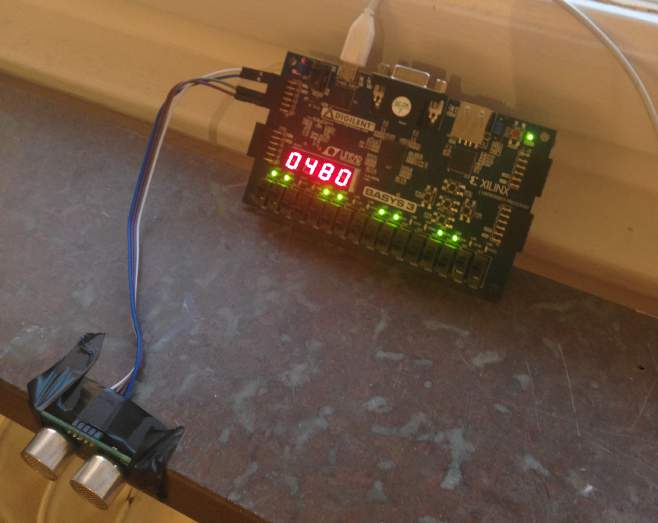
[picture p42: figure]

(c) 480 cm measured

Figure 51: Result of measurements

Figure 51a and 51b shows the measurement with the corresponding LED-meter active.

LED93cm =

93

30
= 4 | (7)

LED371cm =

371

30
= 13 | (8)

Figure 51c shows that the system is capable of distances above 400 cm. This is the full length of the room. The out-of-range pattern on the LED-meter is also active since the distance exceeds the meter limit of 450 cm.

Digital System Design with VHDL (ET062G) | 31

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

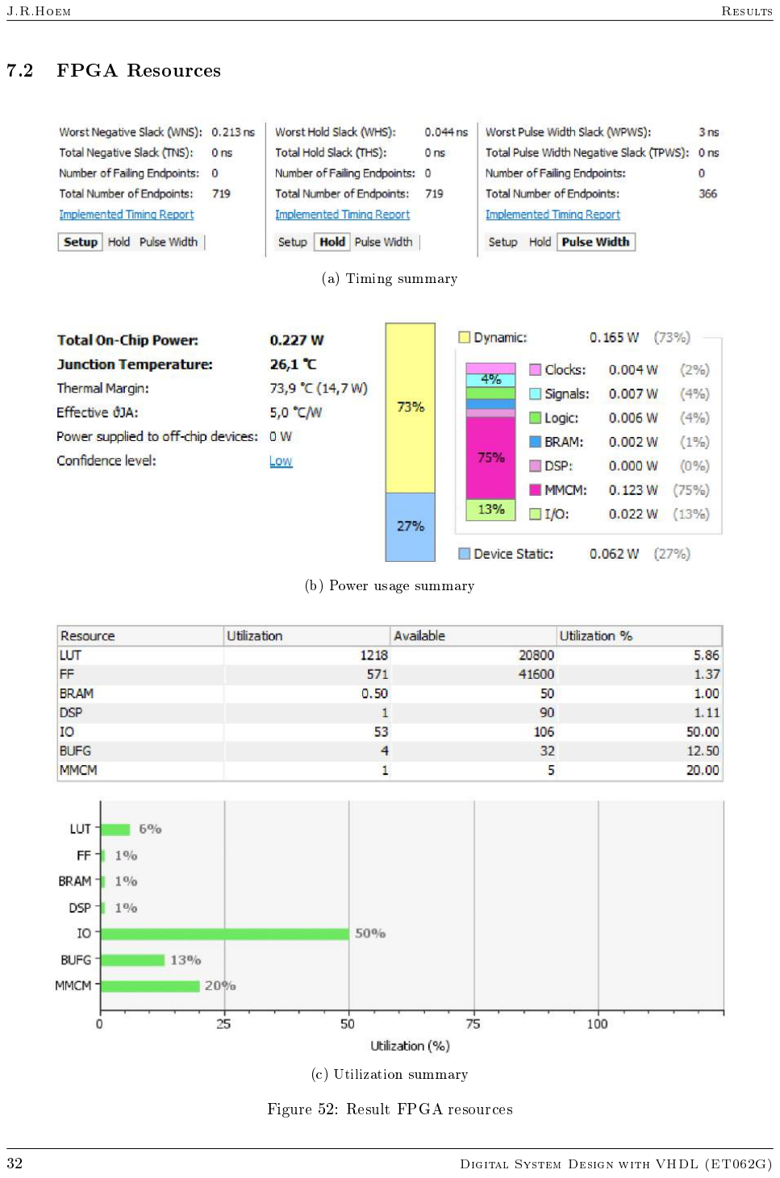
[picture p43: page 37]

Conclusion | J.R.Hoem
8 | Discussion

A lot of considerations have been done in this project. Such as proper RAM implementation, avoiding a secondary reset line[6], structure of the hierarchy, original functionality, general testing and development to name a few. All in all, the results seems to prove that the system is working.

Accuracy

Even though the tests was done as accurate and precise as possible with the equipment that was available: tape, a folding ruler and an near empty room, it can't be considered as a precision test.

For the short range test there was dierent factors that could aect the results, such as noise and the space available. A recurring problem was distances below 10 cm even though the SRF05 documentation claims to be able to handle distances down to 3 cm. The verication and simulation of the SRF05 core have also proven that the system is able to handle distances down to 1 cm.

The long range test on the other hand was surprisingly accurate. A much more inaccurate measurement result was expected due to the observations mentioned in section 4.2.3. The errors that occurred could just as well be human error, especially since it only aected 3 of 10 distances and the errors did not have any similarities with the possible division error. Table 3 and Figure 51c also shows that the system is capable of precise measurements above the maximum range claimed in the datasheets.

Resources

Figure 52a shows that the system does not violate any timing rules.

By looking at Figure 52b one can see that the MMCM, the 108 MHz clock generator, is causing the majority of the power consumption. In a future revision, for testing and if possible, this could be replaced with a PLL to compare the dierences since the MMCM provides more features than the PLL.

Next is the use of I/Os. As mentioned earlier, one of the goals have been to utilize the potential of the Basys3 in regards of user peripherals such as switches, LEDs, etc. Much of this functionality could of course be reduced to save power.

The overall utilization usage, shown in Figure 52c, show that a lot of LUTs and FFs are available for future development. One of the reasons for this is that the RAM is implemented as BRAM.

## 9 Conclusion

Without any prior experience with FPGA or VHDL before this course, this project have been an interesting journey and the learning curve have been steep to say the least. This means that there are probably a lot of adjustments that could be done to improve both the power and resource consumption before the system is (hypothetically) put in production.

When that is said, a lot of time have been invested. Every component is carefully considered and planned as best as possible and have also been simulated and tested thoroughly. The system is working without any glitches or problems. Extra features have been added. The use of FPGA resources and power consumption have been reduced as best as possible.

All in all, the system does the job it is intended to do and should fulll the requirements of this project.

Digital System Design with VHDL (ET062G) | 33

J.R.Hoem | List of Figures

## List of Figures

1 | FPGA with the SRF05 connected | | 1
2 | SRF05 ultrasonic range sensor | | 2
3 | SRF05 beam prole and timing diagram | | 3
4 | VGA timing data for 1280x1024 resolution[1]
| | | 3
5 | System overview, block diagram | | 4
6 | Design overview, block diagram | | 4
7 | Board functionality map | | 5
8 | Entity of jrh_clock_gen_module.vhd | | 6
9 | Entity of clk_wiz_0.vhd | | 6
10 | Entity of jrh_srf05_core.vhd | | 7
11 | Entity of jrh_pulse_gen_module.vhd | | 7
12 | Entity of jrh_echo_analyzer_module.vhd | | 7
13 | Entity of jrh_divider_module.vhd | | 8
14 | Entity of jrh_ram_module.vhd | | 9
15 | Entity of jrh_ram_ctrl_module.vhd | | 9
16 | Principle of circular buers | | 10
17 | Entity of jrh_vga_core.vhd | | 10
18 | Entity of vga_ctrl_module.vhd | | 11
19 | Entity of jrh_norwegian_ag_pattern.vhd | | 12
20 | Entity of testbench_comp_vga2bmp.vhd | | 12
21 | Entity of jrh_led7seg_core.vhd | | 13
22 | 7-Segment Display numbering | | 14
23 | Entity of jrh_bin_to_4bcd_module.vhd | | 14
24 | Entity of jrh_main_top.vhd | | 15
25 | Testing and verication equipment | | 16
26 | Clock simulation: 100 MHz | | 16
27 | Clock simulation: 1 MHz | | 17
28 | Clock simulation: 108 MHz | | 17
29 | SRF05 simulation: echo pulse | | 18
30 | SRF05 simulation: trigger pulse width | | 18
31 | SRF05 simulation: trigger interval | | 18
32 | Verifying SRF05 sensor using signal generator and scope | | 19
33 | Dierent RAM implementations | | 20
34 | Simulation of RAM verication | | 21
35 | Verifying RAM memory by using LEDs | | 22
36 | RAM controller testbench | | 23
37 | VGA testbench result | | 24
38 | VGA to BMP simulation result | | 24
39 | LED and 7-Segment testbench: 397 digit simulation | | 25
40 | LED and 7-Segment testbench: 397 result | | 25
41 | LED and 7-Segment testbench: 9876 digit simulation | | 25
42 | LED and 7-Segment testbench: 9876 result | | 26
43 | Top le testbench simulation results | | 26
44 | Top le testbench simulation results LED/7-Seg | | 27
45 | Top le testbench: LED-meter | | 27
46 | Top le testbench: 7-segment display | | 27
47 | Top le testbench: BMP result | | 28
48 | Testing environment: short range | | 29
49 | Testing environment: long range | | 29
50 | Result: Long and short range plot | | 30
51 | Result of measurements | | 31
52 | Result FPGA resources | | 32
34 | Digital System Design with VHDL (ET062G)

References | | | | | | | | J.R.Hoem

## List of Tables

1 | Basys3 FPGA features | | 2
2 | 7-Segment Display conversion | | 14
3 | Long range test result | | 30
4 | Short range test result | | 30

## References

[1] VESA Signal 1280 x 1024 @ 60 Hz timing, | SECONS Ltd. [Online]. Available: | http:
//tinyvga.com/vga-timing/1280x1024@60Hz
[2] VHDL Entity Instantiation: | Why and How, FPGA-DEV.COM. [Online]. Available: | http:
//www.fpga-dev.com/leaner-vhdl-with-entity-instantiation/
[3] SRF05 Ultrasonic Range Sensor, robot-electronics. [Online]. Available: http://www.robot-electronics.co.uk/htm/srf05tech.htm (http://www.robot-electronics.co.uk/htm/srf05tech.htm)
[4] Ultrasonic Rangers FAQ, robot-electronics. [Online]. Available: http://www.robot-electronics.co.uk/htm/sonar_faq.htm (http://www.robot-electronics.co.uk/htm/sonar_faq.htm)
[5] Basys 3TM FPGA Board Reference Manual, Digilent, 4 2016, rev. C. [Online]. Available: https://reference.digilentinc.com/_media/basys3:basys3_rm.pdf
[6] What | are | FPGA | Power | Management | HDL | Coding | Techniques, | Xil-
inx | Training, | 2012. | [Online]. | Available: | http://www.xilinx.com/training/downloads/
what-are-fpga-power-management-hdl-coding-techniques.pptx (http://www.xilinx.com/training/downloads/what-are-fpga-power-management-hdl-coding-techniques.pptx)
Digital System Design with VHDL (ET062G) | 35

10 | Appendices
10.A | Project les

All of the project les is supplied with this report in a separate compressed le.

jrh_vhdl_files_ET062G.zip

bitstream

<bitstream file>

images

<bmp-files from VGA simulation>

reports

<most relevant reports from Vivado>

vhdl_range_project

<all of the Vivado project files>

project_files

<all of the VHDL code>

The VHDL code can also be found at:

https://github.com/jorgenrh/ET062G_VHDL_Range_Sensor

10.B Top File code

jrh_main_top.vhd

1 | ----------------------------------------------------------------------------------
2 | -- Author: | Jørgen Ryther Hoem
3 | --
4 | -- Course: | Digital System Design with VHDL (ET062G)
5 | -- | Mid Sweden University, 2016
6 | --
7 | -- Module Name: | jrh_main_top - Behavioral
8 | -- Project Name: | Range Sensor System
9 | -- Description: | Main top file for the project
10 | ----------------------------------------------------------------------------------
11
12 | library ieee;
13 | use ieee.std_logic_1164.all;
14 | use ieee.numeric_std.all;
15
16
17 entity jrh_main_top is
18
19 | port(
20 | -- General
21 | clock_in | : in | std_logic;
22 | enable_in | : in | std_logic;
23 | reset_in | : in | std_logic;
24
25 | -- SRF05
26 | echo_pulse_in | : in | std_logic;
27 | trig_pulse_out : out std_logic;
28 | led_out | : out std_logic_vector(15 downto 0) := (others => ’0’);
29
30 | -- LCD
31 | lcd_segment | : out std_logic_vector(6 downto 0) := (others => ’0’);
32 | lcd_position | : out std_logic_vector(3 downto 0) := (others => ’1’);
33
34 | -- VGA
35 | vga_hsync | : out std_logic := ’0’;
36 | vga_vsync | : out std_logic := ’0’;
37 | vga_red | : out std_logic_vector(3 downto 0) := (others => ’0’);
38 | vga_blue | : out std_logic_vector(3 downto 0) := (others => ’0’);
39 | vga_green | : out std_logic_vector(3 downto 0) := (others => ’0’);
40
41 | -- Data display options
42 | cont_sw | : in | std_logic := ’0’;
43 | half_sw | : in | std_logic := ’0’;
44 | push_btn | : in | std_logic_vector(4 downto 0) := (others => ’0’)
45 | );
46
47 end jrh_main_top;
48
49 architecture Behavioral of jrh_main_top is 50
51 | -- clock signals
52 | signal clock_vga | : std_logic := ’0’;
53 | signal clock_slow : std_logic := ’0’;
54
55 | -- sensor signals

56 | signal int_distance : std_logic_vector(15 downto 0) := (others => ’0’);
57
58 begin
59
60 | CLOCK_GENERATOR:
61 | entity work.clock_gen_module
62 | port map(
63 | clock_100mhz_in | => clock_in,
64 | clock_108mhz_out => clock_vga,
65 | clock_1mhz_out | => clock_slow
66 | );
67
68 | SRF05_SENSOR:
69 | entity work.srf05_core
70 | port map(
71 | clock_in | => clock_slow,
72 | enable_in | => enable_in,
73 | echo_pulse_in | => echo_pulse_in,
74 | trig_pulse_out => trig_pulse_out,
75 | distance_out | => int_distance
76 | );
77
78 | LED_7SEGMENT:
79 | entity work.led7seg_core
80 | port map(
81 | clock_in | => clock_slow,
82 | binary_in | => int_distance,
83 | segment_out | => lcd_segment,
84 | position_out => lcd_position,
85 | led_out | => led_out
86 | );
87
88 | VGA_GRAPHICS:
89 | entity work.vga_core
90 | port map(
91 | clock_in | => clock_vga,
92 | clock_slow => clock_slow,
93 | reset_in | => reset_in,
94 | data_in | => int_distance,
95 | vga_hsync | => vga_hsync,
96 | vga_vsync | => vga_vsync,
97 | vga_red | => vga_red,
98 | vga_blue | => vga_blue,
99 | vga_green | => vga_green,
100 | cont_sw | => cont_sw,
101 | half_sw | => half_sw,
102 | push_btn | => push_btn
103 | );
104
105
106
107 end Behavioral;

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

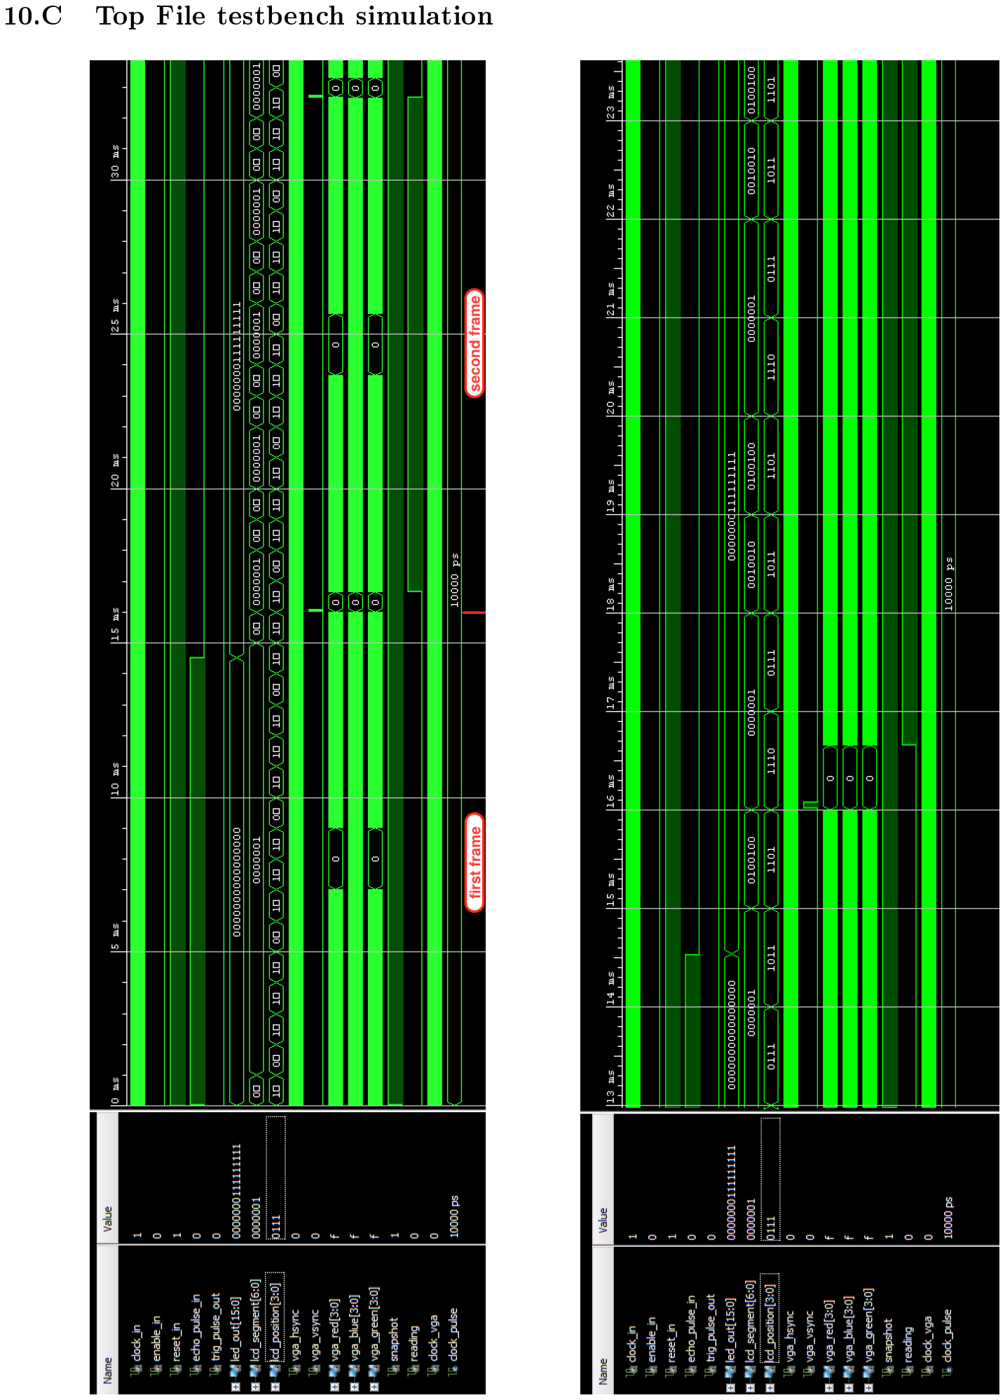
[picture p44: page 44]

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

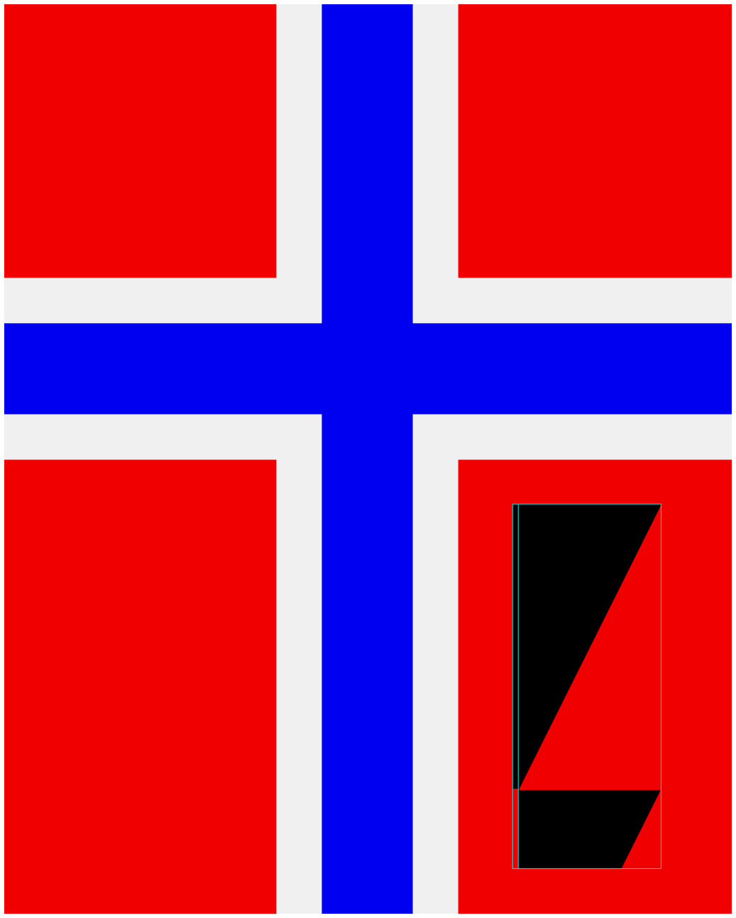
[picture p45: figure]

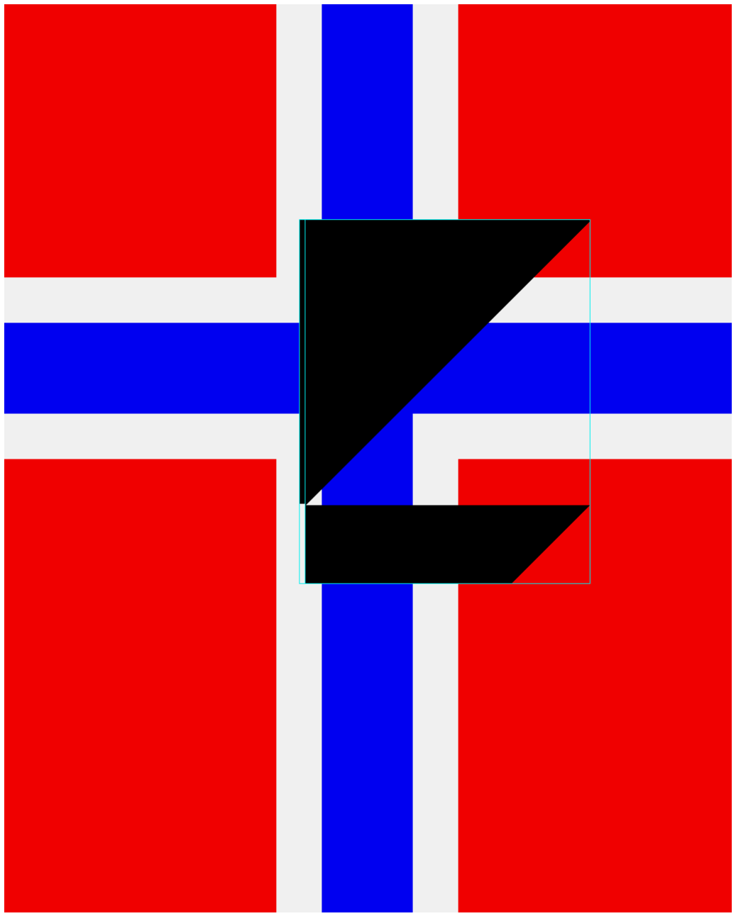
[picture p46: figure]
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
