jorgenrh/ET062G_VHDL_Range_Sensor/images/design.png

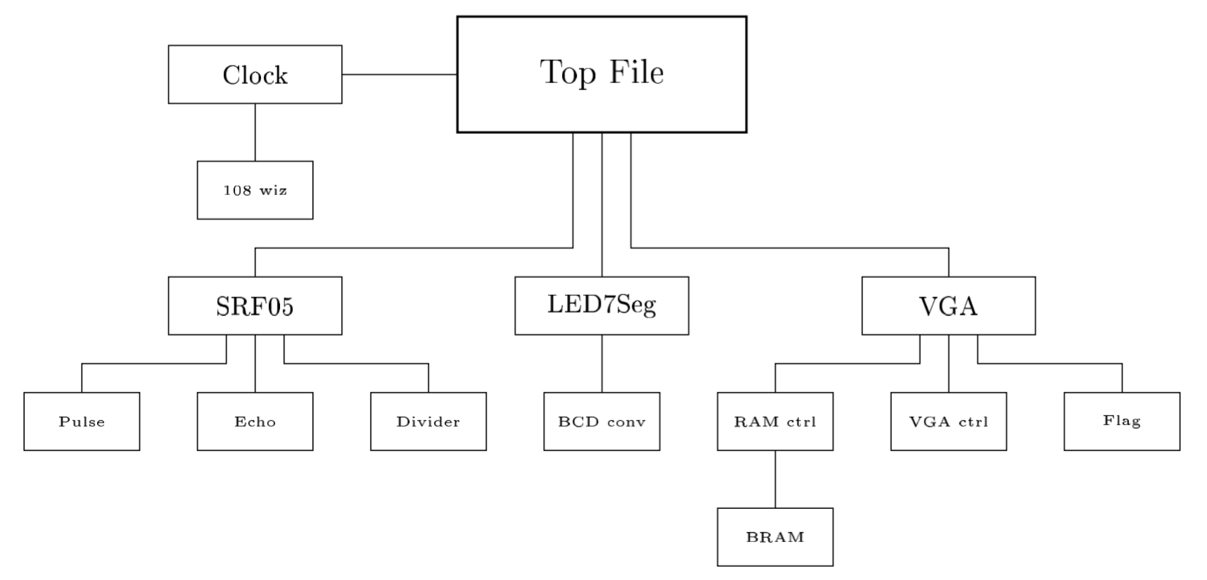
images/design.png
