jorgenrh/ET062G_VHDL_Range_Sensor/images/resources.png

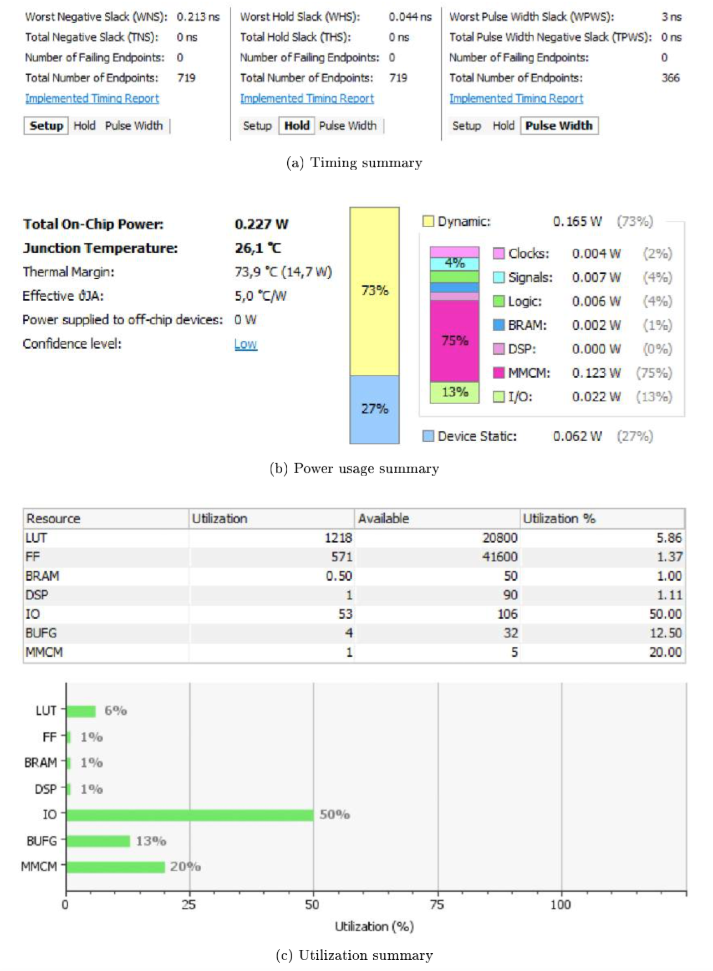
images/resources.png
