jorgenrh/ET062G_VHDL_Range_Sensor/images/system.png

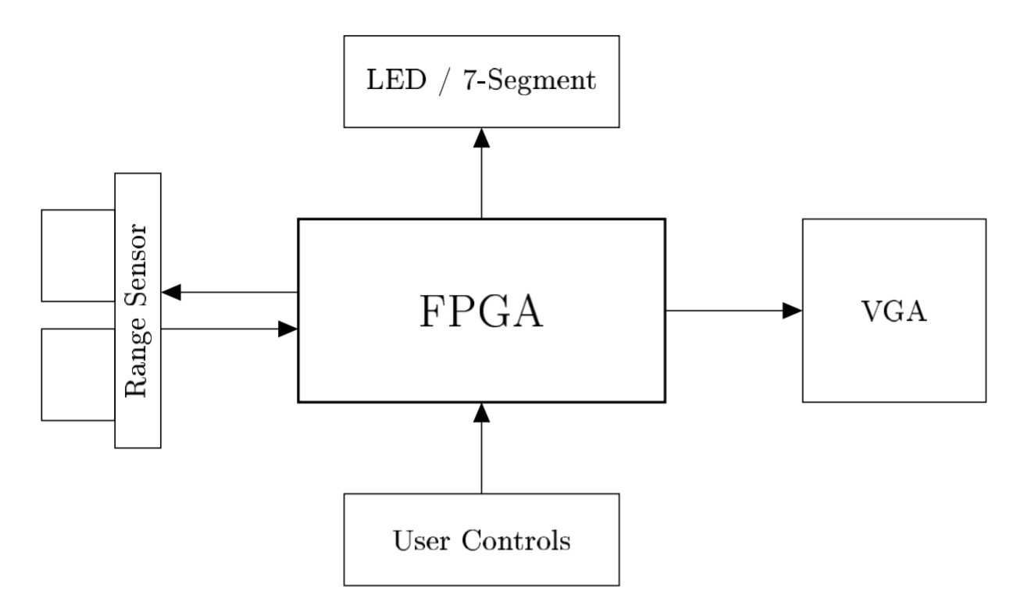
images/system.png
