jorgenrh/ET062G_VHDL_Range_Sensor/jrh_echo_analyzer_module.vhd

----------------------------------------------------------------------------------
-- Author:        Jørgen Ryther Hoem
--
-- Course:        Digital System Design with VHDL (ET062G)     
--                Mid Sweden University, 2016
-- 
-- Module Name:   jrh_echo_analyzer_module - Behavioral
-- Project Name:  Range Sensor System
-- Description:   Echo pulse analyzer, part of the SRF05 core
----------------------------------------------------------------------------------

library ieee;
use ieee.std_logic_1164.all; 
use ieee.numeric_std.all;


entity echo_analyzer_module is

    port (
        clock_in     : in  std_logic;
        pulse_in     : in  std_logic;
        duration_out : out std_logic_vector(15 downto 0) := (others => '0')
    );

end echo_analyzer_module;

architecture Behavioral of echo_analyzer_module is

begin

    process(clock_in, pulse_in)
        
        variable duration : integer := 0;
        variable counting : std_logic := '0';
        variable timeout  : std_logic := '0';
        
    begin

        if clock_in'event and clock_in = '1' then    

            -- count the length if timeout is not set
            if pulse_in = '1' and timeout = '0' then
            
                if counting = '0' then
                    duration := 1;
                    counting := '1';
                else       
                    duration := duration + 1;
                end if;
                
            -- echo pulse is low, set the duration out signal
            elsif pulse_in = '0' then
    
                counting := '0';
                timeout := '0';
                duration_out <= std_logic_vector(to_unsigned(duration, 16));
                
            end if;

            -- check if timeout and set duration to 0
            -- and timeout flag to 1 if true
            if duration >= 30000 then
            
                timeout := '1';
                duration := 0;
                duration_out <= (others => '0');
                
            end if;


        end if;

    end process;

end Behavioral;
