jorgenrh/ET062G_VHDL_Range_Sensor/jrh_srf05_core.vhd

----------------------------------------------------------------------------------
-- Author:        Jørgen Ryther Hoem
--
-- Course:        Digital System Design with VHDL (ET062G)     
--                Mid Sweden University, 2016
-- 
-- Module Name:   jrh_srf05_core - Behavioral
-- Project Name:  Range Sensor System
-- Description:   SRF05 core, handles all the sensor functionality
----------------------------------------------------------------------------------

library ieee;
use ieee.numeric_std.all;
use ieee.std_logic_1164.all; 

entity srf05_core is

    port (
        clock_in       : in  std_logic := '0';
        enable_in      : in  std_logic := '0';
        echo_pulse_in  : in  std_logic := '0';
        trig_pulse_out : out std_logic := '0';
        distance_out   : out std_logic_vector(15 downto 0) := (others => '0')
    );
    
end srf05_core;

architecture Behavioral of srf05_core is
  
    signal int_duration : std_logic_vector(15 downto 0) := (others => '0');
    
    -- initialize trigger pulse with 5 -> 10 + 5 us -> 15 us trigger pulse
    constant int_pwidth : std_logic_vector(3 downto 0) := std_logic_vector(to_unsigned(5, 4));     
    
begin
    
    ECHO_MODULE: 
        entity work.echo_analyzer_module 
        port map(
            clock_in  => clock_in,
            pulse_in  => echo_pulse_in,
            duration_out => int_duration
        );
    
    PULSE_MODULE: 
        entity work.pulse_gen_module 
        port map(
            clock_in  => clock_in,
            enable_in => enable_in,
            pwidth_in => int_pwidth,
            pulse_out => trig_pulse_out
        );
    
    DIV_MODULE: 
        entity work.divider_module 
        port map (
            clock_in  => clock_in,
            data_in   => int_duration,
            data_out  => distance_out
        );


end Behavioral;
